Kreyl/LedPicture/Control/beleriand.jpg

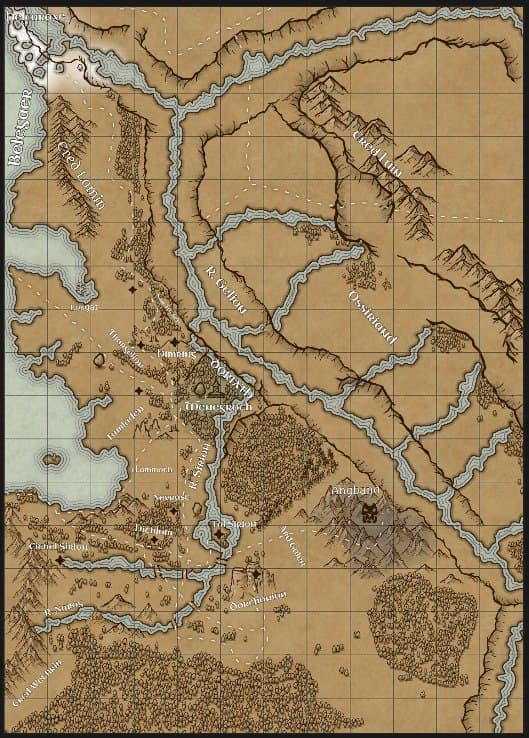
Control/beleriand.jpg
