Kreyl/LedPicture/LedPicture_hw/LedPicture.kicad_pcb

## KiCad design LedPicture_hw/LedPicture.kicad_pcb (2021-07-11)

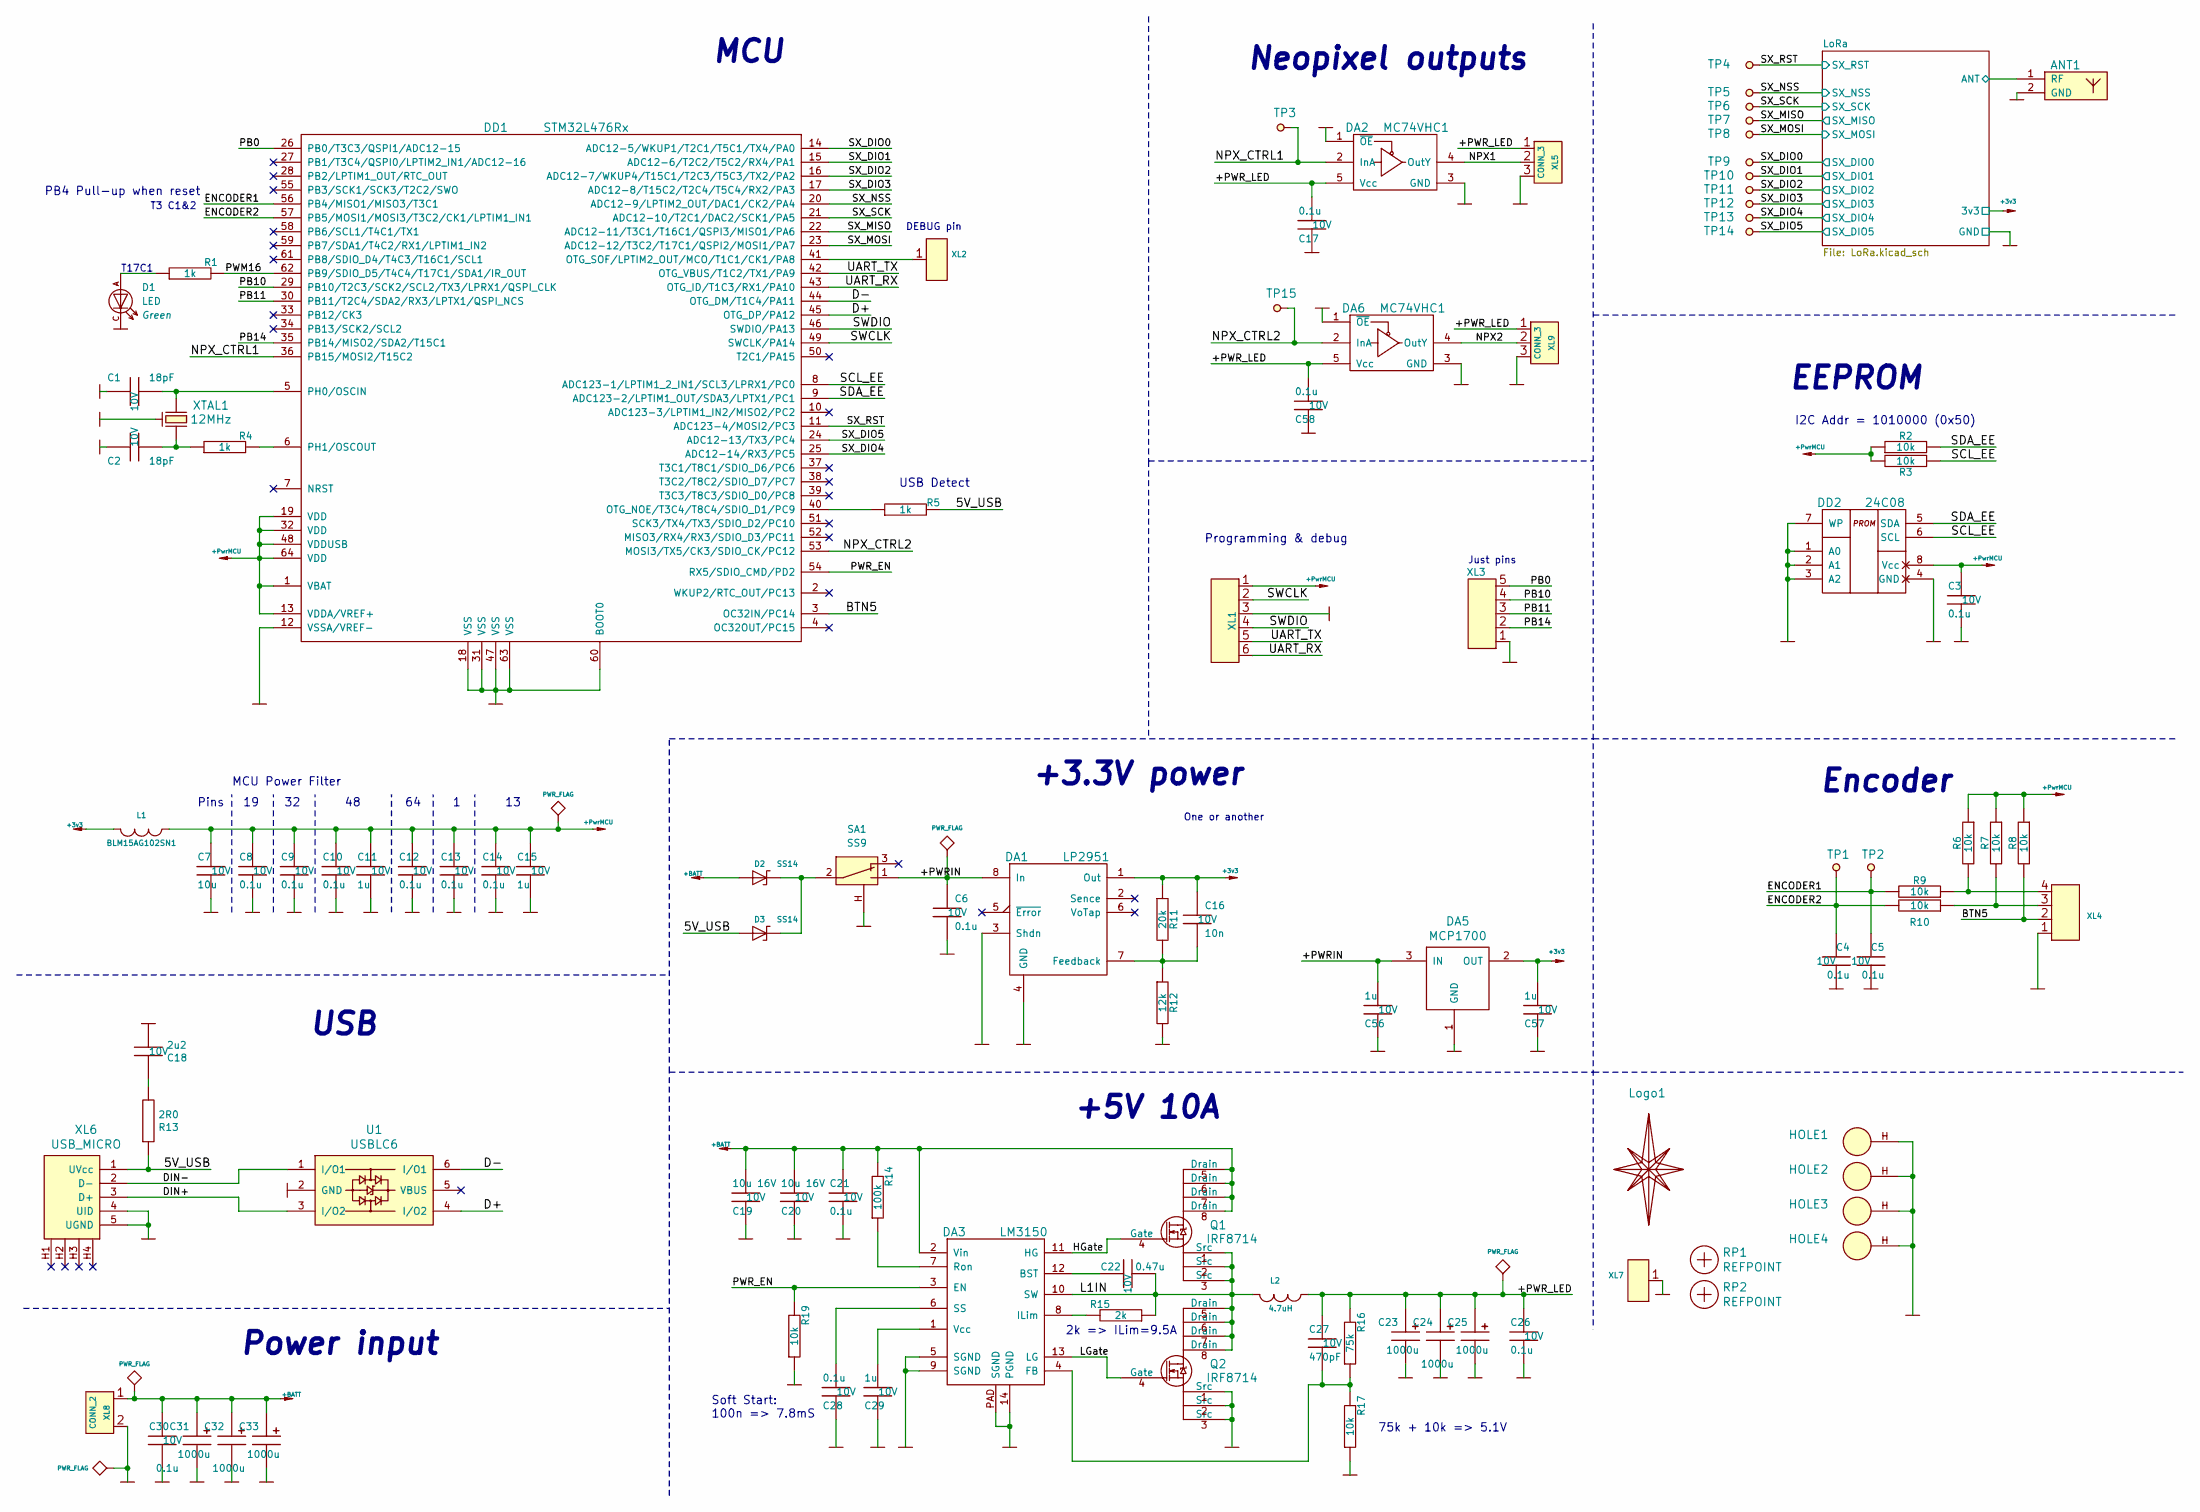
[picture p2: schematic LedPicture.kicad_sch]

Parts:
ANT1: ANT_GENERAL; ANT_868_IFA_SIMPLEJOY
C1, C2: 18pF; CAP_0603_Silks; Tolerance 20%; Voltage 10V
C3, C4, C5, C6, C8, C9, C10, C12, C13, C14, C17, C21, C26, C28, C30, C58: 0.1u; CAP_0603_Silks; Tolerance 20%; Voltage 10V
C7: 10u; CAP_0603_Silks; Tolerance 20%; Voltage 10V
C11, C15, C29, C56, C57: 1u; CAP_0603_Silks; Tolerance 20%; Voltage 10V
C16: 10n; CAP_0603_Silks; Tolerance 20%; Voltage 10V
C18: 2u2; CAP_0603_Silks; Tolerance 20%; Voltage 10V
C19, C20: 10u 16V; CAP_0603_Silks; Tolerance 20%; Voltage 10V
C22: 0.47u; CAP_0603_Silks; Tolerance 20%; Voltage 10V
C23, C24, C25, C31, C32, C33: 1000u; CAP_10xxR
C27: 470pF; CAP_0603_Silks; Tolerance 20%; Voltage 10V
D1: LED; LED_0603
D2, D3: SS14; SMA_DO214AC
DA1: LP2951; SO8_150MIL
DA2, DA6: MC74VHC1; SOT23-5
DA3: LM3150; HTSSOP14
DA5: MCP1700; SOT23-3A
DD1: STM32L476Rx; LQFP64
DD2: 24C08; SO8_150MIL
HOLE1, HOLE2, HOLE3, HOLE4: HOLE_METALLED; Hole3_5_out6mm
L1: BLM15AG102SN1; IND_0402; Tolerance 20%
L2: 4.7uH; 13x13
Logo1: Logo; Ostranna_16d9_13d5
Q1, Q2: IRF8714; SO8_150MIL
R1, R4, R5: 1k; RES_0603; Tolerance 1%
R2, R3, R6, R7, R8, R9, R10, R17, R19: 10k; RES_0603; Tolerance 1%
R11: 20k; RES_0603; Tolerance 1%
R12: 12k; RES_0603; Tolerance 1%
R13: 2R0; RES_0603; Tolerance 1%
R14: 100k; RES_0603; Tolerance 1%
R15: 2k; RES_0603; Tolerance 1%
R16: 75k; RES_0603; Tolerance 1%
RP1, RP2: REFPOINT; REF_POINT_1MM
SA1: SS9; SW_SS9
TP1, TP2, TP3, TP4, TP5, TP6, TP7, TP8, TP9, TP10, TP11, TP12, TP13, TP14, TP15: TESTPOINT; TESTPOINT_1MM
U1: USBLC6; SOT23-6
XL1: CONN_6; PLS-6_LOCK
XL2, XL7: CONN_1; PLS-1Rnd
XL3: CONN_5; PLS-5
XL4: CONN_4; WB-04(MW-4M)
XL5, XL9: CONN_3; TermiBlockHeader_508_x3_R
XL6: USB_MICRO; USBmicro_MOLEX_1050170001
XL8: CONN_2; TermiBlockHeader_508_x2_R
XTAL1: 12MHz; 03225C4

Connections:
+3v3: C16.1, C57.1, DA1.1 (Out), DA5.2 (OUT), L1.2, R11.1; also elsewhere on the board
+BATT: C19.1, C20.1, C21.2, C30.2, C31.1, C32.1, C33.1, D2.A, DA3.2 (Vin), Q1.5 (Drain), Q1.6 (Drain), Q1.7 (Drain), Q1.8 (Drain), R14.2, XL8.1
/5V_USB: D3.A, R5.2, R13.1, XL6.1 (UVcc)
/+PWRIN: C6.1, C56.1, DA1.8 (In), DA5.3 (IN), SA1.1
/+PWR_LED: C17.1, C23.1, C24.1, C25.1, C26.2, C27.2, C58.1, DA2.5 (Vcc), DA6.5 (Vcc), L2.1, R16.2, XL5.1, XL9.1
/BTN5: DD1.3 (OC32IN/PC14), R8.2, XL4.2 (PM)
/D+: DD1.45 (OTG_DP/PA12), U1.4 (I/O2)
/D-: DD1.44 (OTG_DM/T1C4/PA11), U1.6 (I/O1)
/DIN+: U1.3 (I/O2), XL6.3 (D+)
/DIN-: U1.1 (I/O1), XL6.2 (D-)
/ENCODER1: C5.2, DD1.56 (PB4/MISO1/MISO3/T3C1), R9.2, TP2.1
/ENCODER2: C4.2, DD1.57 (PB5/MOSI1/MOSI3/T3C2/CK1/LPTIM1_IN1), R10.2, TP1.1
/HGate: DA3.11 (HG), Q1.4 (Gate)
/L1IN: C22.1, DA3.10 (SW), L2.2, Q1.1 (Src), Q1.2 (Src), Q1.3 (Src), Q2.5 (Drain), Q2.6 (Drain), Q2.7 (Drain), Q2.8 (Drain), R15.1
/LGate: DA3.13 (LG), Q2.4 (Gate)
/LoRa/ANT: ANT1.1 (RF); also elsewhere on the board
/NPX1: DA2.4 (OutY), XL5.2 (PM)
/NPX2: DA6.4 (OutY), XL9.2 (PM)
/NPX_CTRL1: DA2.2 (InA), DD1.36 (PB15/MOSI2/T15C2), TP3.1
/NPX_CTRL2: DA6.2 (InA), DD1.53 (MOSI3/TX5/CK3/SDIO_CK/PC12), TP15.1
/PB0: DD1.26 (PB0/T3C3/QSPI1/ADC12-15), XL3.5
/PB10: DD1.29 (PB10/T2C3/SCK2/SCL2/TX3/LPRX1/QSPI_CLK), XL3.4
/PB11: DD1.30 (PB11/T2C4/SDA2/RX3/LPTX1/QSPI_NCS), XL3.3
/PB14: DD1.35 (PB14/MISO2/SDA2/T15C1), XL3.2
/PWM16: DD1.62 (PB9/SDIO_D5/T4C4/T17C1/SDA1/IR_OUT), R1.2
/PWR_EN: DA3.3 (EN), DD1.54 (RX5/SDIO_CMD/PD2), R19.2
/SCL_EE: DD1.8 (ADC123-1/LPTIM1_2_IN1/SCL3/LPRX1/PC0), DD2.6 (SCL), R3.1
/SDA_EE: DD1.9 (ADC123-2/LPTIM1_OUT/SDA3/LPTX1/PC1), DD2.5 (SDA), R2.2
/SWCLK: DD1.49 (SWCLK/PA14), XL1.2
/SWDIO: DD1.46 (SWDIO/PA13), XL1.4
/SX_DIO0: DD1.14 (ADC12-5/WKUP1/T2C1/T5C1/TX4/PA0), TP9.1; also elsewhere on the board
/SX_DIO1: DD1.15 (ADC12-6/T2C2/T5C2/RX4/PA1), TP10.1; also elsewhere on the board
/SX_DIO2: DD1.16 (ADC12-7/WKUP4/T15C1/T2C3/T5C3/TX2/PA2), TP11.1; also elsewhere on the board
/SX_DIO3: DD1.17 (ADC12-8/T15C2/T2C4/T5C4/RX2/PA3), TP12.1; also elsewhere on the board
/SX_DIO4: DD1.25 (ADC12-14/RX3/PC5), TP13.1; also elsewhere on the board
/SX_DIO5: DD1.24 (ADC12-13/TX3/PC4), TP14.1; also elsewhere on the board
/SX_MISO: DD1.22 (ADC12-11/T3C1/T16C1/QSPI3/MISO1/PA6), TP7.1; also elsewhere on the board
/SX_MOSI: DD1.23 (ADC12-12/T3C2/T17C1/QSPI2/MOSI1/PA7), TP8.1; also elsewhere on the board
/SX_NSS: DD1.20 (ADC12-9/LPTIM2_OUT/DAC1/CK2/PA4), TP5.1; also elsewhere on the board
/SX_RST: DD1.11 (ADC123-4/MOSI2/PC3), TP4.1; also elsewhere on the board
/SX_SCK: DD1.21 (ADC12-10/T2C1/DAC2/SCK1/PA5), TP6.1; also elsewhere on the board
/UART_RX: DD1.43 (OTG_ID/T1C3/RX1/PA10), XL1.6
/UART_TX: DD1.42 (OTG_VBUS/T1C2/TX1/PA9), XL1.5
GND: ANT1.2 (GND), C1.2, C2.2, C3.1, C4.1, C5.1, C6.2, C7.1, C8.1, C9.1, C10.1, C11.1, C12.1, C13.1, C14.1, C15.1, C17.2, C18.2, C19.2, C20.2, C21.1, C23.2, C24.2, C25.2, C26.1, C28.2, C29.2, C30.1, C31.2, C32.2, C33.2, C56.2, C57.2, C58.2, D1.C, DA1.3 (Shdn), DA1.4 (GND), DA2.1 (~OE), DA2.3 (GND), DA3.5 (SGND), DA3.9 (SGND), DA3.14 (PGND), DA3.PAD (SGND), DA5.1 (GND), DA6.1 (~OE), DA6.3 (GND), DD1.12 (VSSA/VREF-), DD1.18 (VSS), DD1.31 (VSS), DD1.47 (VSS), DD1.60 (BOOT0), DD1.63 (VSS), DD2.1 (A0), DD2.2 (A1), DD2.3 (A2), DD2.4 (GND), DD2.7 (WP), HOLE1.H, HOLE2.H, HOLE3.H, HOLE4.H, Q2.1 (Src), Q2.2 (Src), Q2.3 (Src), R12.2, R17.1, R19.1, SA1.H, U1.2 (GND), XL1.3, XL3.1, XL4.1, XL5.3, XL6.4 (UID), XL6.5 (UGND), XL7.1, XL8.2 (PM), XL9.3, XTAL1.H; also elsewhere on the board
unnamed: C1.1, DD1.5 (PH0/OSCIN), XTAL1.1
unnamed: C2.1, R4.1, XTAL1.2
unnamed: C16.2, DA1.7 (Feedback), R11.2, R12.1
unnamed: C18.1, R13.2
unnamed: C22.2, DA3.12 (BST)
unnamed: C27.1, DA3.4 (FB), R16.1, R17.2
unnamed: C28.1, DA3.6 (SS)
unnamed: C29.1, DA3.1 (Vcc)
unnamed: D1.A, R1.1
unnamed: D2.C, D3.C, SA1.2
unnamed: DA3.7 (Ron), R14.1
unnamed: DA3.8 (ILim), R15.2
unnamed: DD1.6 (PH1/OSCOUT), R4.2
unnamed: DD1.40 (OTG_NOE/T3C4/T8C4/SDIO_D1/PC9), R5.1
unnamed: DD1.41 (OTG_SOF/LPTIM2_OUT/MCO/T1C1/CK1/PA8), XL2.1
unnamed: R6.2, R9.1, XL4.4
unnamed: R7.2, R10.1, XL4.3

Notes on the sheet:
PB4 Pull-up when reset
T17C1
T3 C1&2
Pins 19 32 48 64 1 13
MCU Power Filter
Power input
USB
MCU
Soft Start: 100n => 7.8mS
USB Detect
DEBUG pin
+3.3V power
2k => ILim=9.5A
+5V 10A
One or another
Programming & debug
Neopixel outputs
75k + 10k => 5.1V
Just pins
EEPROM
I2C Addr = 1010000 (0x50)
Encoder

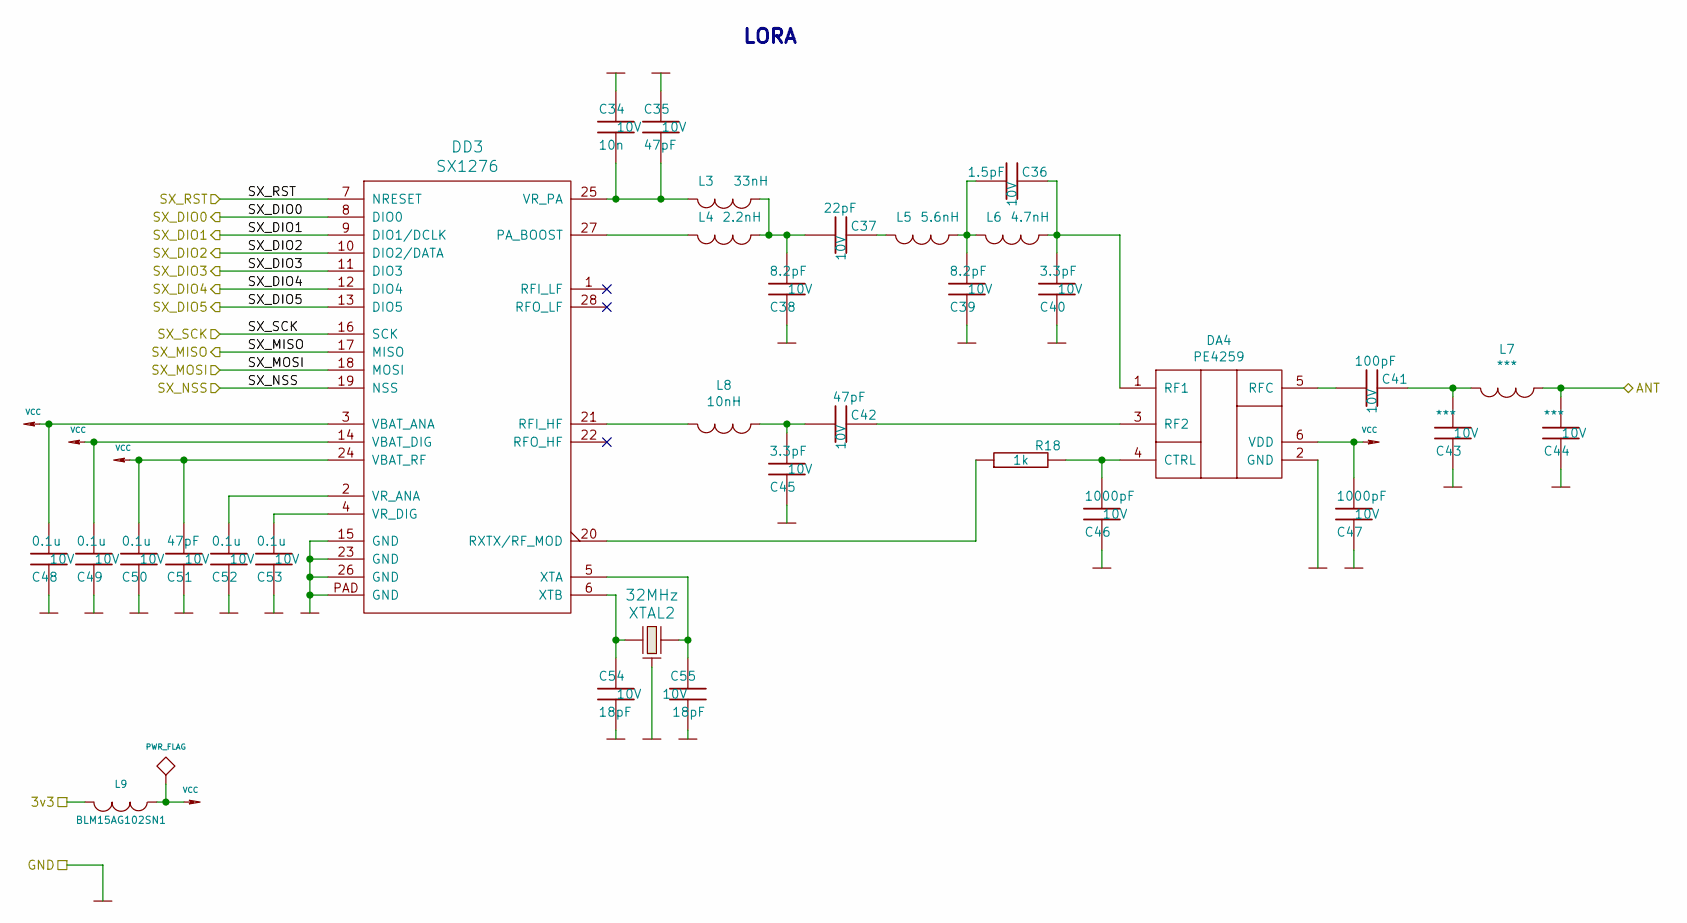
[picture p3: schematic LoRa.kicad_sch]

Parts:
C34: 10n; CAP_0402; Tolerance 20%; Voltage 10V
C35, C42, C51: 47pF; CAP_0402; Tolerance 20%; Voltage 10V
C36: 1.5pF; CAP_0402; Tolerance 20%; Voltage 10V
C37: 22pF; CAP_0402; Tolerance 20%; Voltage 10V
C38, C39: 8.2pF; CAP_0402; Tolerance 20%; Voltage 10V
C40, C45: 3.3pF; CAP_0402; Tolerance 20%; Voltage 10V
C41: 100pF; CAP_0402; Tolerance 20%; Voltage 10V
C43, C44: ***; CAP_0402; Tolerance 20%; Voltage 10V
C46, C47: 1000pF; CAP_0402; Tolerance 20%; Voltage 10V
C48, C49, C50, C52, C53: 0.1u; CAP_0402; Tolerance 20%; Voltage 10V
C54, C55: 18pF; CAP_0603_Silks; Tolerance 20%; Voltage 10V
DA4: PE4259; SC70
DD3: SX1276; QFN-28_EP_6x6_Pitch0.65mm
L3: 33nH; IND_0402; Tolerance 20%
L4: 2.2nH; IND_0402; Tolerance 20%
L5: 5.6nH; IND_0402; Tolerance 20%
L6: 4.7nH; IND_0402; Tolerance 20%
L7: ***; IND_0402; Tolerance 20%
L8: 10nH; IND_0402; Tolerance 20%
L9: BLM15AG102SN1; IND_0402; Tolerance 20%
R18: 1k; RES_0603; Tolerance 1%
XTAL2: 32MHz; 03225C4

Connections:
+3v3: L9.2; also elsewhere on the board
/LoRa/ANT: C44.1, L7.2; also elsewhere on the board
/SX_DIO0: DD3.8 (DIO0); also elsewhere on the board
/SX_DIO1: DD3.9 (DIO1/DCLK); also elsewhere on the board
/SX_DIO2: DD3.10 (DIO2/DATA); also elsewhere on the board
/SX_DIO3: DD3.11 (DIO3); also elsewhere on the board
/SX_DIO4: DD3.12 (DIO4); also elsewhere on the board
/SX_DIO5: DD3.13 (DIO5); also elsewhere on the board
/SX_MISO: DD3.17 (MISO); also elsewhere on the board
/SX_MOSI: DD3.18 (MOSI); also elsewhere on the board
/SX_NSS: DD3.19 (NSS); also elsewhere on the board
/SX_RST: DD3.7 (NRESET); also elsewhere on the board
/SX_SCK: DD3.16 (SCK); also elsewhere on the board
GND: C34.2, C35.2, C38.2, C39.2, C40.2, C43.2, C44.2, C45.2, C46.2, C47.2, C48.2, C49.2, C50.2, C51.2, C52.2, C53.2, C54.2, C55.2, DA4.2 (GND), DD3.15 (GND), DD3.23 (GND), DD3.26 (GND), DD3.PAD (GND), XTAL2.H; also elsewhere on the board
unnamed: C34.1, C35.1, DD3.25 (VR_PA), L3.1
unnamed: C36.1, C40.1, DA4.1 (RF1), L6.2
unnamed: C36.2, C39.1, L5.2, L6.1
unnamed: C37.1, L5.1
unnamed: C37.2, C38.1, L3.2, L4.2
unnamed: C41.1, C43.1, L7.1
unnamed: C41.2, DA4.5 (RFC)
unnamed: C42.1, DA4.3 (RF2)
unnamed: C42.2, C45.1, L8.2
unnamed: C46.1, DA4.4 (CTRL), R18.2
unnamed: C52.1, DD3.2 (VR_ANA)
unnamed: C53.1, DD3.4 (VR_DIG)
unnamed: C54.1, DD3.6 (XTB), XTAL2.2
unnamed: C55.1, DD3.5 (XTA), XTAL2.1
unnamed: DD3.20 (RXTX/RF_MOD), R18.1
unnamed: DD3.21 (RFI_HF), L8.1
unnamed: DD3.27 (PA_BOOST), L4.1
VCC: C47.1, C48.1, C49.1, C50.1, C51.1, DA4.6 (VDD), DD3.3 (VBAT_ANA), DD3.14 (VBAT_DIG), DD3.24 (VBAT_RF), L9.1

Notes on the sheet:
LORA

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
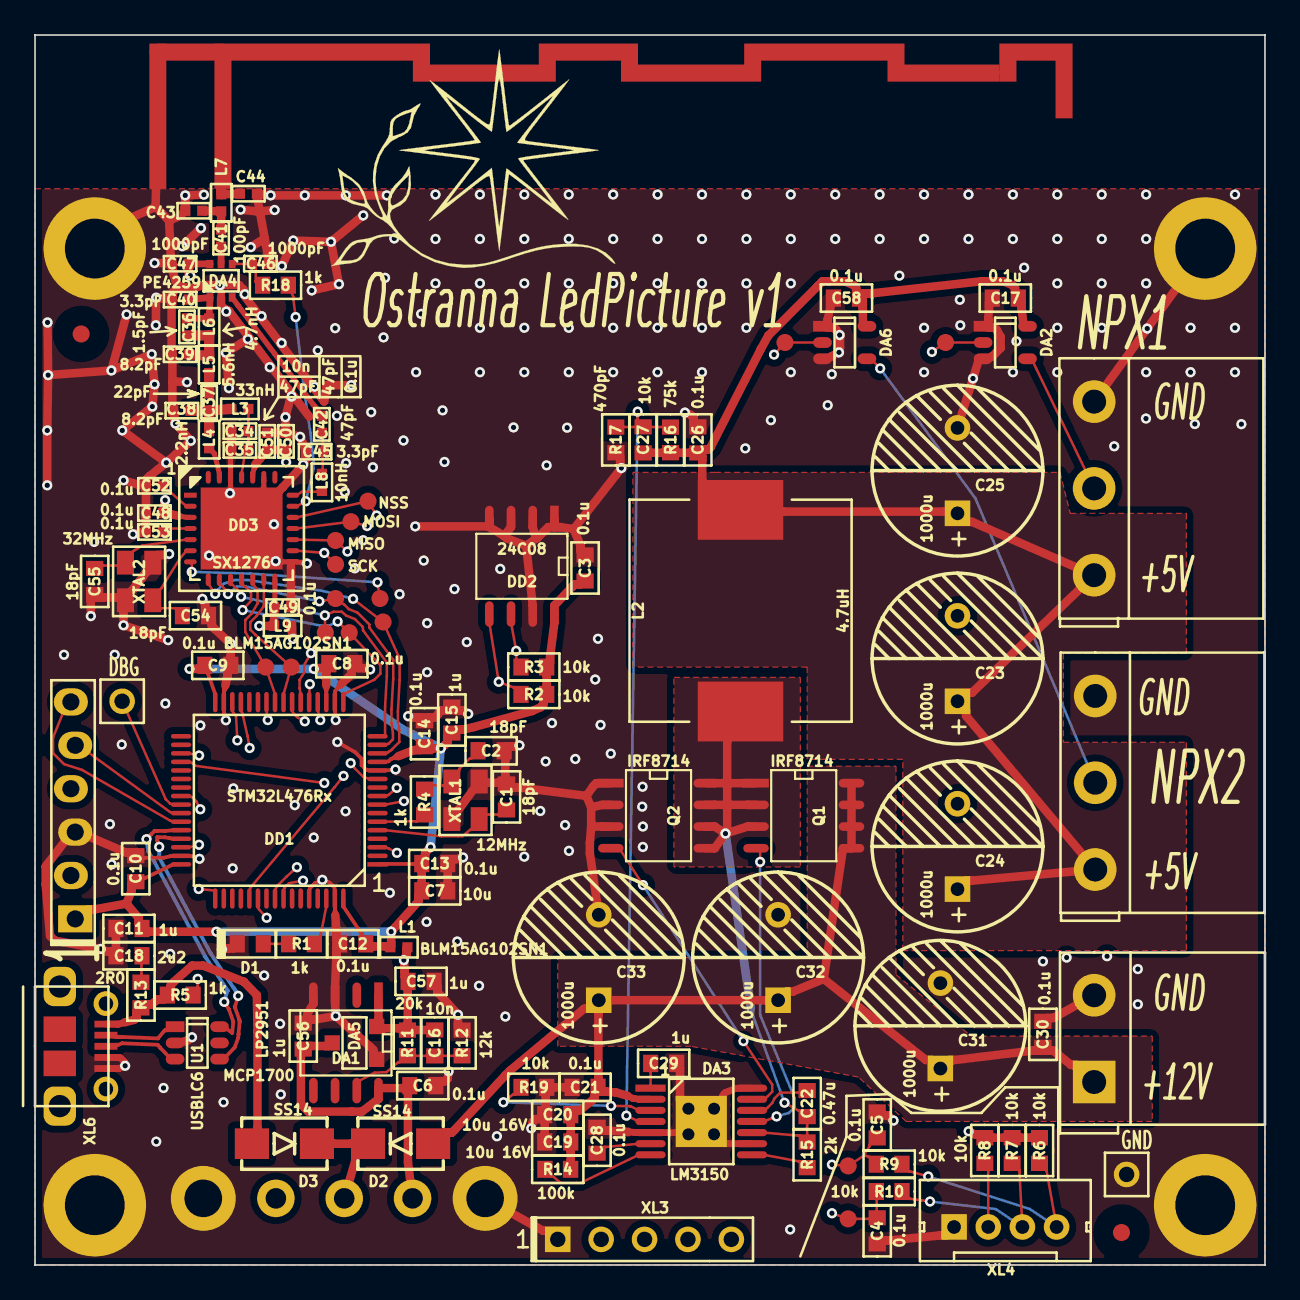
[picture p4: board LedPicture.kicad_pcb from above]

Board: 4 copper layers, 72.0 x 72.0 mm, 136 parts (1 on the bottom side), 80 nets.
