Kreyl/LedPicture/LedPcb10x14/LedPcb10x14.kicad_pcb

## KiCad design LedPcb10x14/LedPcb10x14.kicad_pcb (2021-07-11)

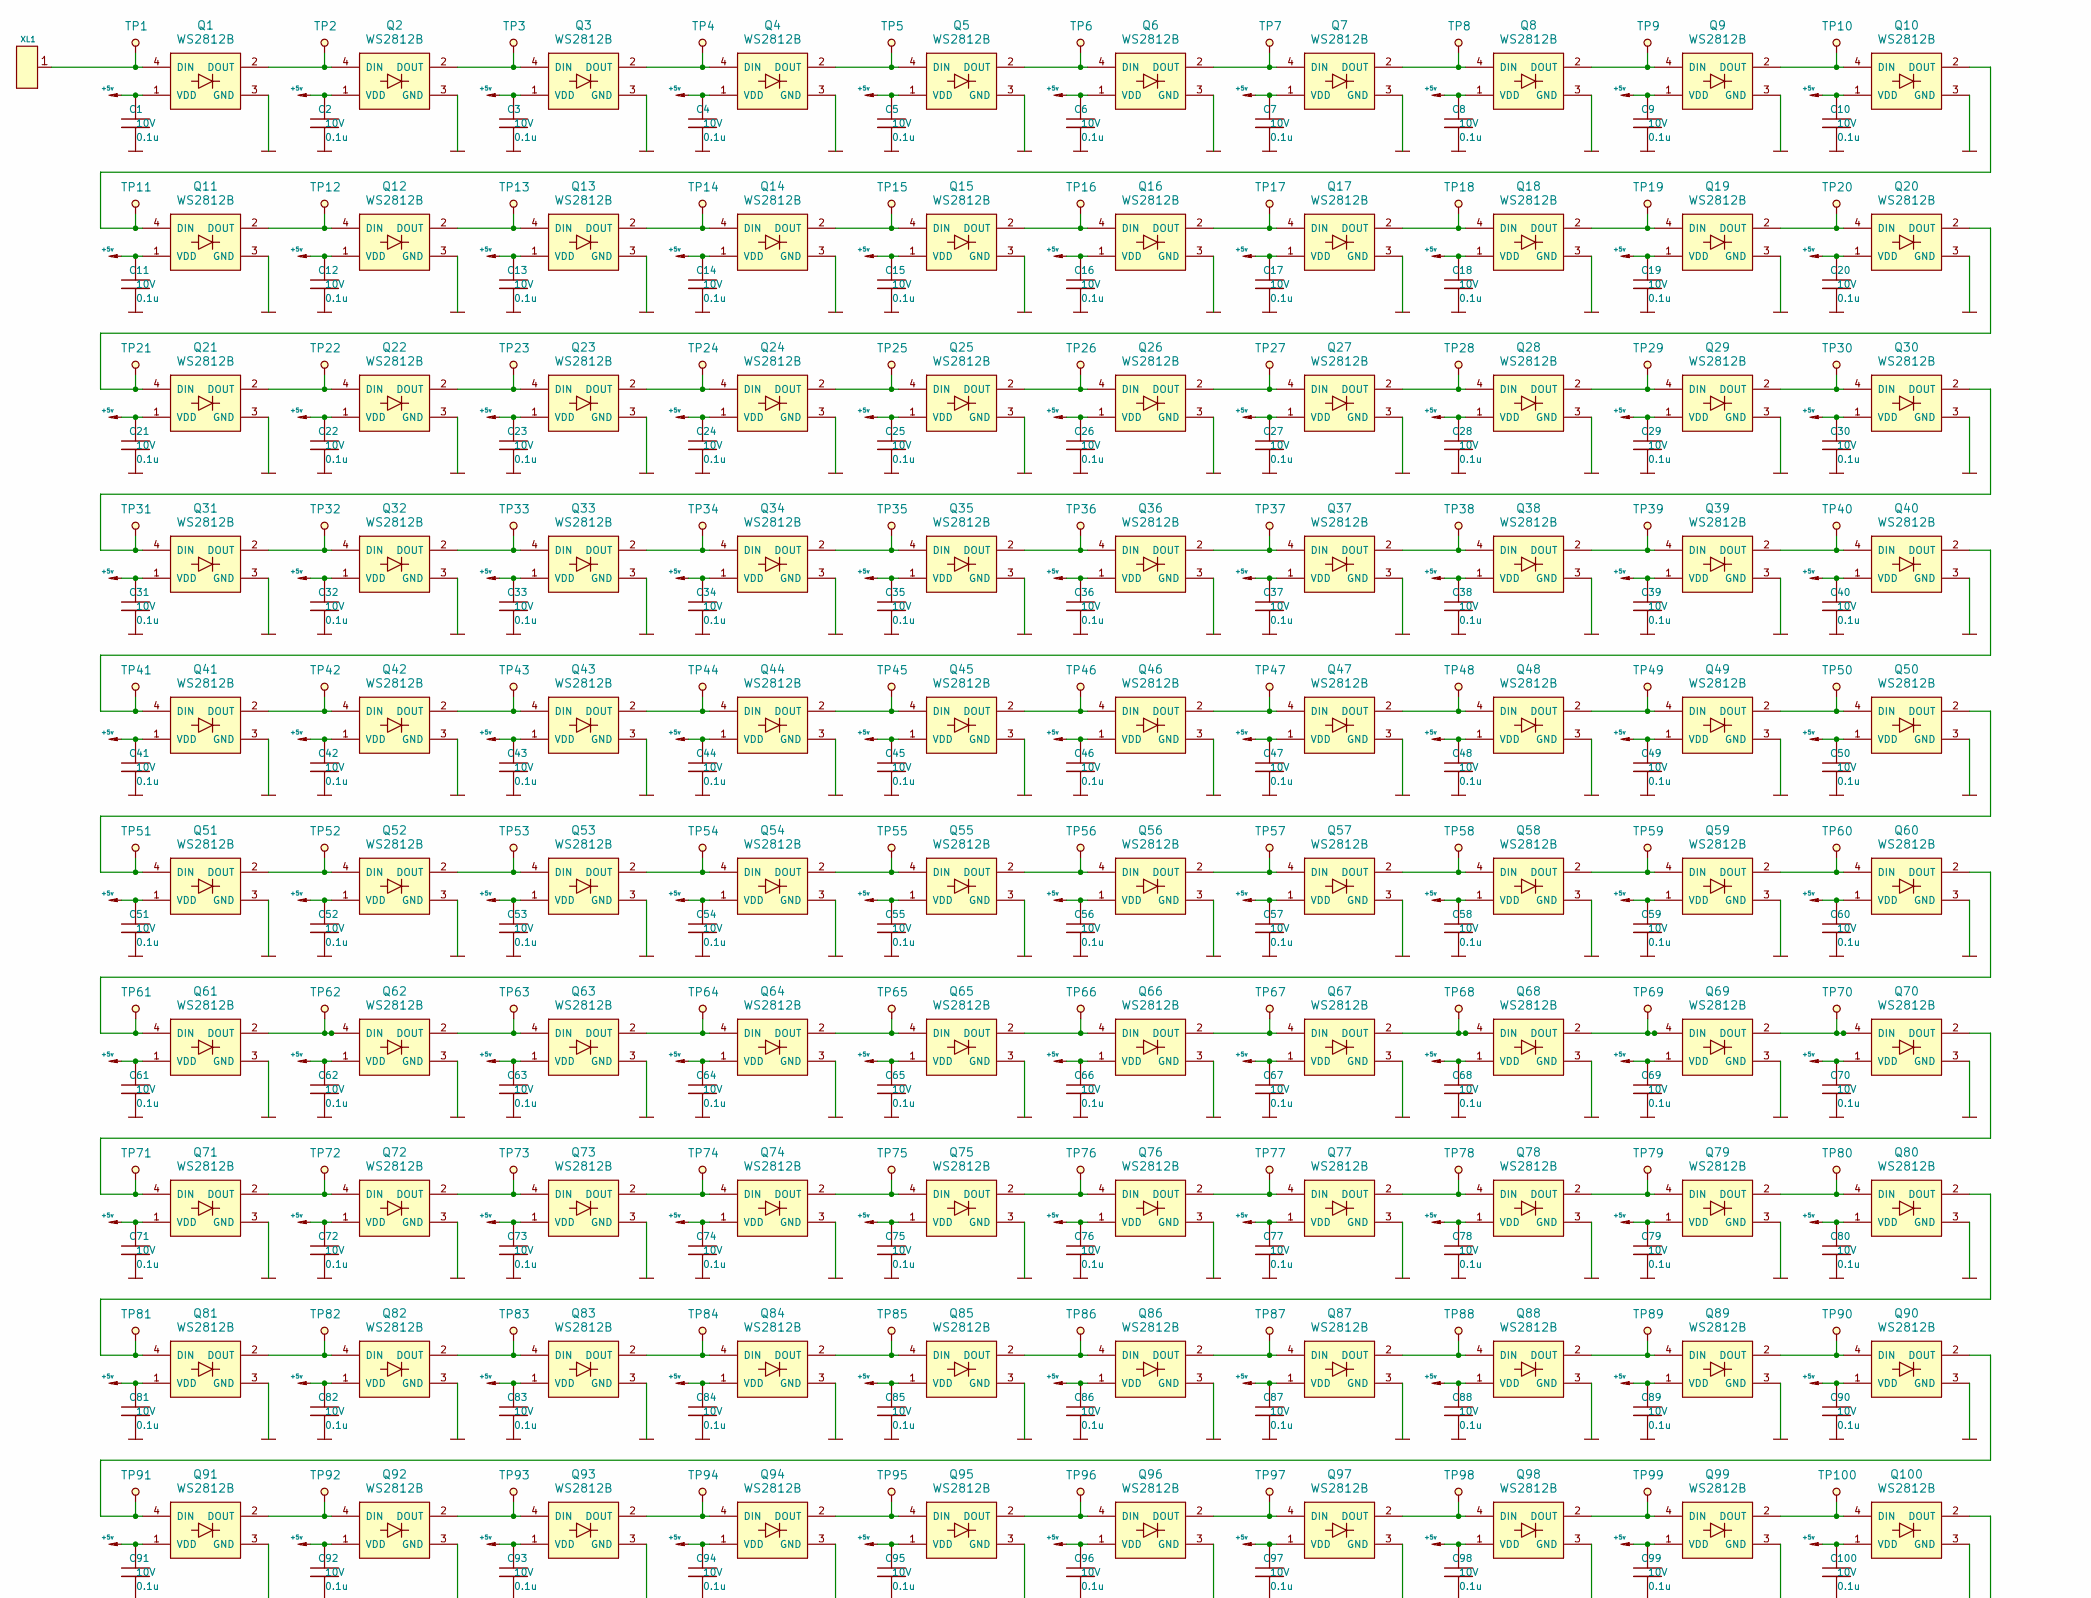
[picture p5: schematic LedPcb10x14.kicad_sch, part in row 1, column 1]

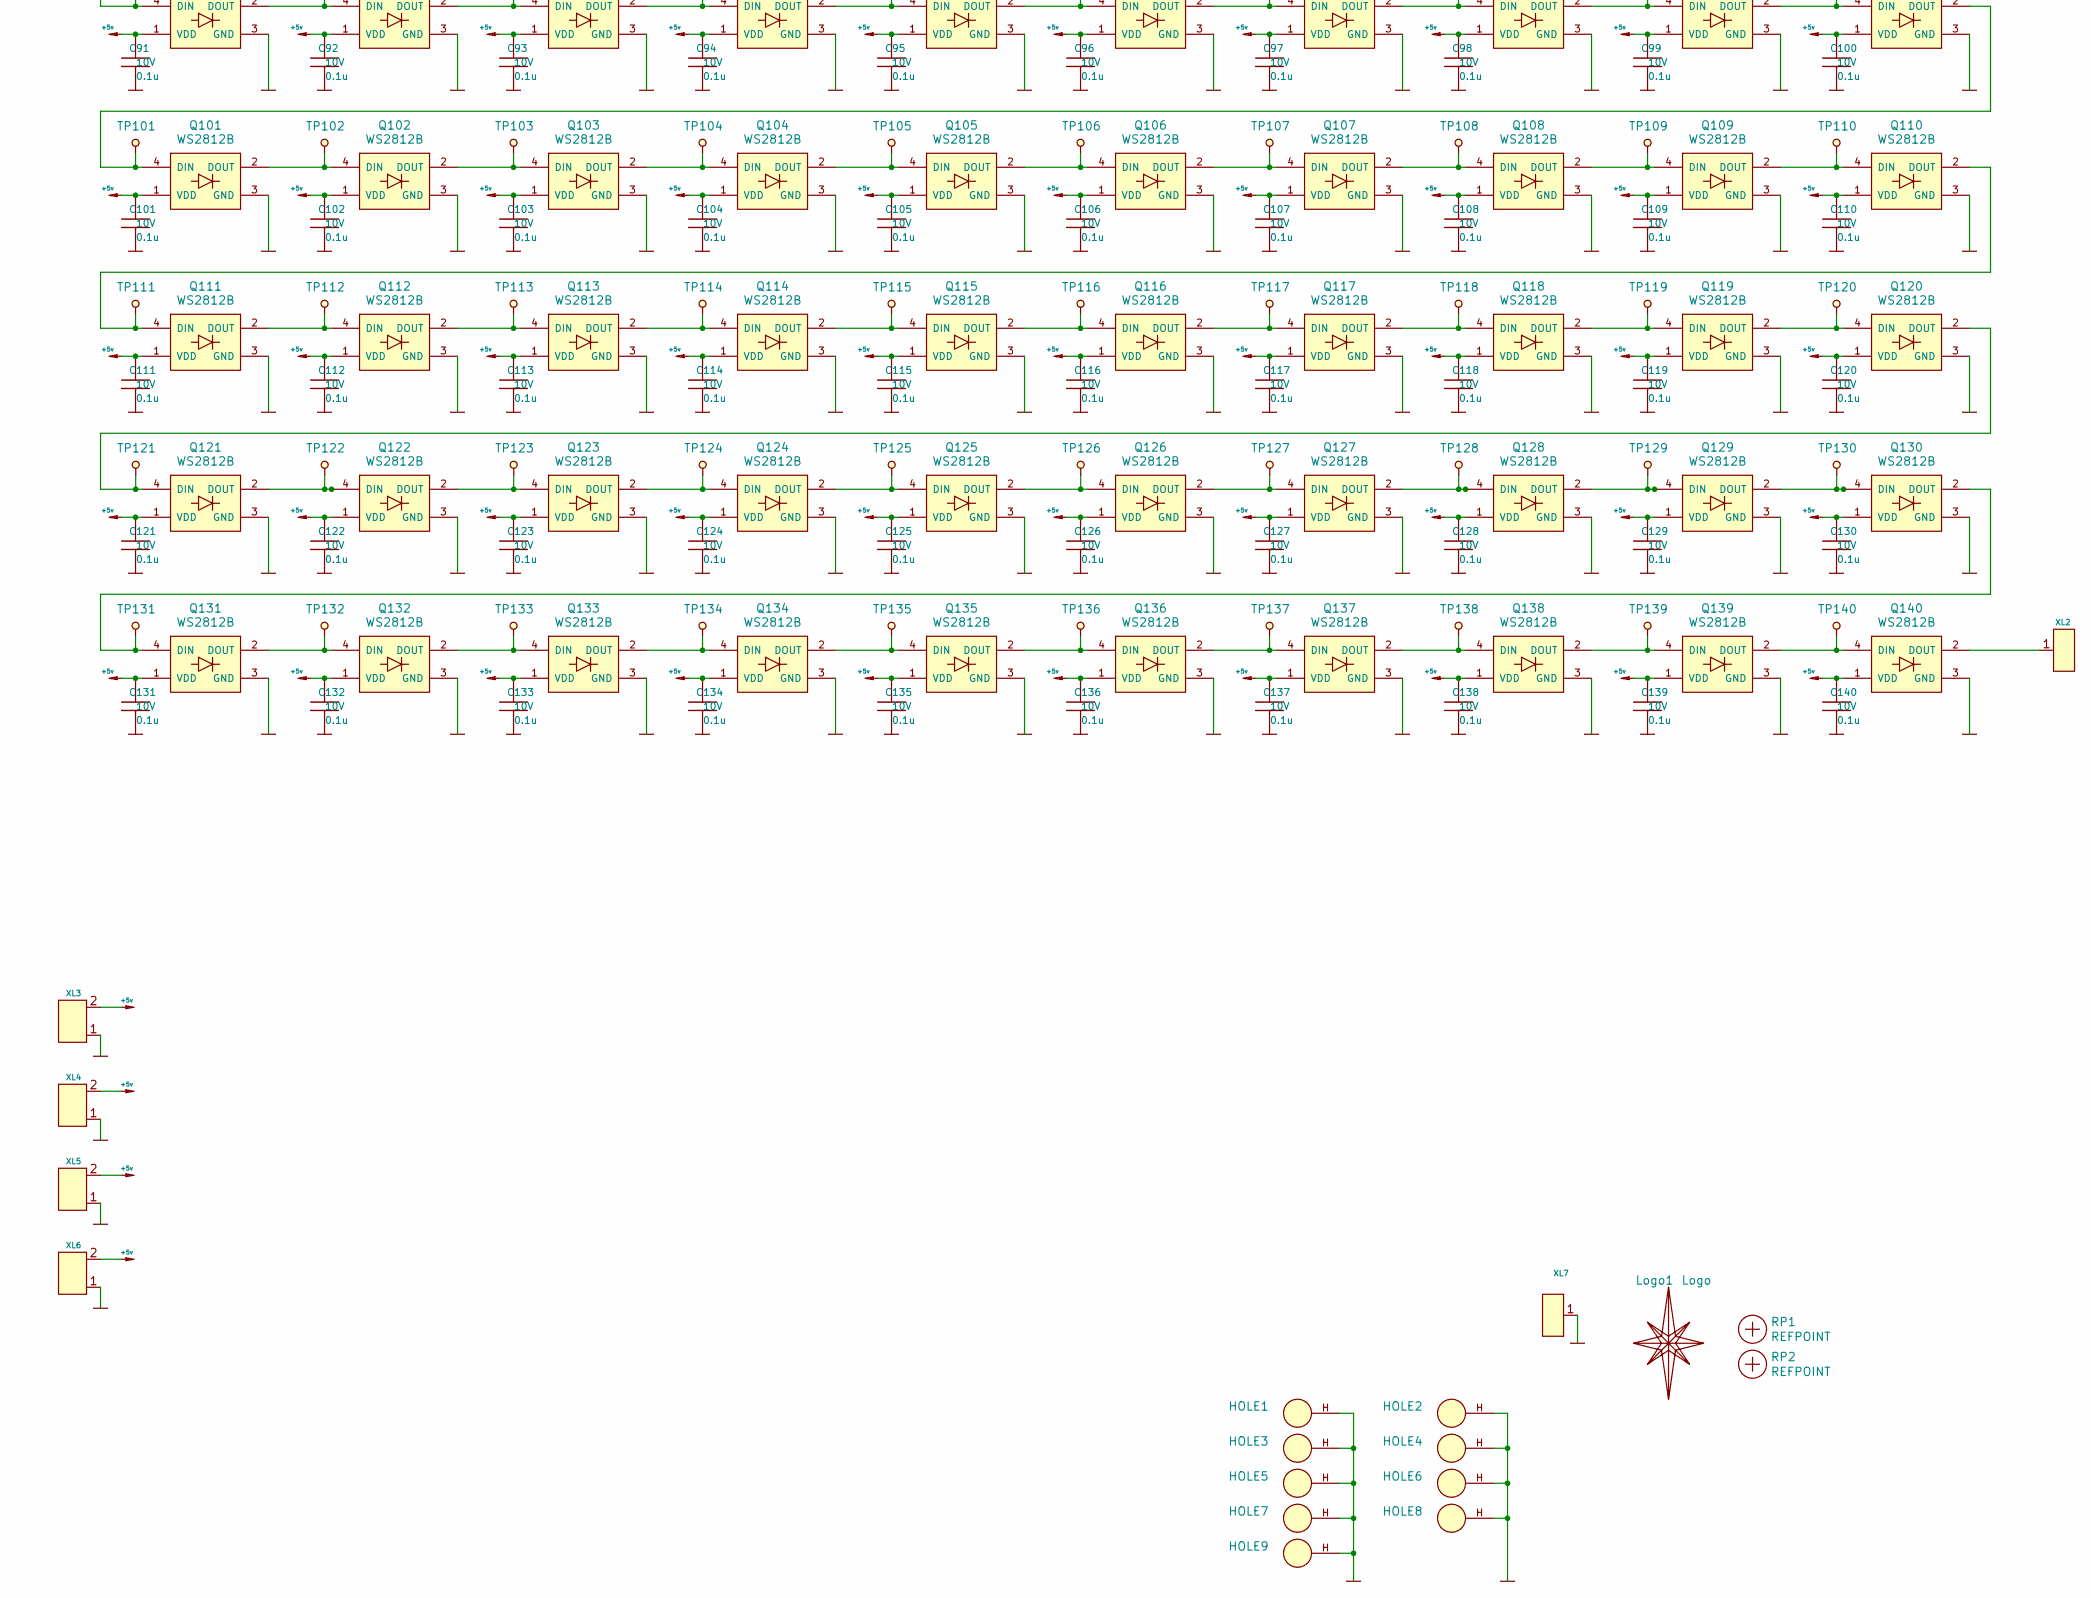
[picture p6: schematic LedPcb10x14.kicad_sch, part in row 2, column 1]

Parts:
C1, C2, C3, C4, C5, C6, C7, C8, C9, C10, C11, C12, C13, C14, C15, C16, C17, C18, C19, C20, C21, C22, C23, C24, C25, C26, C27, C28, C29, C30, C31, C32, C33, C34, C35, C36, C37, C38, C39, C40, C41, C42, C43, C44, C45, C46, C47, C48, C49, C50, C51, C52, C53, C54, C55, C56, C57, C58, C59, C60, C61, C62, C63, C64, C65, C66, C67, C68, C69, C70, C71, C72, C73, C74, C75, C76, C77, C78, C79, C80, C81, C82, C83, C84, C85, C86, C87, C88, C89, C90, C91, C92, C93, C94, C95, C96, C97, C98, C99, C100, C101, C102, C103, C104, C105, C106, C107, C108, C109, C110, C111, C112, C113, C114, C115, C116, C117, C118, C119, C120, C121, C122, C123, C124, C125, C126, C127, C128, C129, C130, C131, C132, C133, C134, C135, C136, C137, C138, C139, C140: 0.1u; CAP_0603_Silks; Tolerance 20%; Voltage 10V
HOLE1, HOLE2, HOLE3, HOLE4, HOLE5, HOLE6, HOLE7, HOLE8, HOLE9: HOLE_METALLED; Hole2d2_out3d5mm
Logo1: Logo; Ostranna_12d7_10d1
Q1, Q2, Q3, Q4, Q5, Q6, Q7, Q8, Q9, Q10, Q11, Q12, Q13, Q14, Q15, Q16, Q17, Q18, Q19, Q20, Q21, Q22, Q23, Q24, Q25, Q26, Q27, Q28, Q29, Q30, Q31, Q32, Q33, Q34, Q35, Q36, Q37, Q38, Q39, Q40, Q41, Q42, Q43, Q44, Q45, Q46, Q47, Q48, Q49, Q50, Q51, Q52, Q53, Q54, Q55, Q56, Q57, Q58, Q59, Q60, Q61, Q62, Q63, Q64, Q65, Q66, Q67, Q68, Q69, Q70, Q71, Q72, Q73, Q74, Q75, Q76, Q77, Q78, Q79, Q80, Q81, Q82, Q83, Q84, Q85, Q86, Q87, Q88, Q89, Q90, Q91, Q92, Q93, Q94, Q95, Q96, Q97, Q98, Q99, Q100, Q101, Q102, Q103, Q104, Q105, Q106, Q107, Q108, Q109, Q110, Q111, Q112, Q113, Q114, Q115, Q116, Q117, Q118, Q119, Q120, Q121, Q122, Q123, Q124, Q125, Q126, Q127, Q128, Q129, Q130, Q131, Q132, Q133, Q134, Q135, Q136, Q137, Q138, Q139, Q140: WS2812B; LED_WS2812B
RP1, RP2: REFPOINT; REF_POINT_1MM
TP1, TP2, TP3, TP4, TP5, TP6, TP7, TP8, TP9, TP10, TP11, TP12, TP13, TP14, TP15, TP16, TP17, TP18, TP19, TP20, TP21, TP22, TP23, TP24, TP25, TP26, TP27, TP28, TP29, TP30, TP31, TP32, TP33, TP34, TP35, TP36, TP37, TP38, TP39, TP40, TP41, TP42, TP43, TP44, TP45, TP46, TP47, TP48, TP49, TP50, TP51, TP52, TP53, TP54, TP55, TP56, TP57, TP58, TP59, TP60, TP61, TP62, TP63, TP64, TP65, TP66, TP67, TP68, TP69, TP70, TP71, TP72, TP73, TP74, TP75, TP76, TP77, TP78, TP79, TP80, TP81, TP82, TP83, TP84, TP85, TP86, TP87, TP88, TP89, TP90, TP91, TP92, TP93, TP94, TP95, TP96, TP97, TP98, TP99, TP100, TP101, TP102, TP103, TP104, TP105, TP106, TP107, TP108, TP109, TP110, TP111, TP112, TP113, TP114, TP115, TP116, TP117, TP118, TP119, TP120, TP121, TP122, TP123, TP124, TP125, TP126, TP127, TP128, TP129, TP130, TP131, TP132, TP133, TP134, TP135, TP136, TP137, TP138, TP139, TP140: TESTPOINT; TESTPOINT_1MM
XL1, XL2: CONN_1; PLS-1Oval
XL3, XL4, XL5, XL6: CONN_2; TermiBlockHeader_508_x2_R
XL7: CONN_1; PLS-1Square

Connections:
+5v: C1.1, C2.1, C3.1, C4.1, C5.1, C6.1, C7.1, C8.1, C9.1, C10.1, C11.1, C12.1, C13.1, C14.1, C15.1, C16.1, C17.1, C18.1, C19.1, C20.1, C21.1, C22.1, C23.1, C24.1, C25.1, C26.1, C27.1, C28.1, C29.1, C30.1, C31.1, C32.1, C33.1, C34.1, C35.1, C36.1, C37.1, C38.1, C39.1, C40.1, C41.1, C42.1, C43.1, C44.1, C45.1, C46.1, C47.1, C48.1, C49.1, C50.1, C51.1, C52.1, C53.1, C54.1, C55.1, C56.1, C57.1, C58.1, C59.1, C60.1, C61.1, C62.1, C63.1, C64.1, C65.1, C66.1, C67.1, C68.1, C69.1, C70.1, C71.1, C72.1, C73.1, C74.1, C75.1, C76.1, C77.1, C78.1, C79.1, C80.1, C81.1, C82.1, C83.1, C84.1, C85.1, C86.1, C87.1, C88.1, C89.1, C90.1, C91.1, C92.1, C93.1, C94.1, C95.1, C96.1, C97.1, C98.1, C99.1, C100.1, C101.1, C102.1, C103.1, C104.1, C105.1, C106.1, C107.1, C108.1, C109.1, C110.1, C111.1, C112.1, C113.1, C114.1, C115.1, C116.1, C117.1, C118.1, C119.1, C120.1, C121.1, C122.1, C123.1, C124.1, C125.1, C126.1, C127.1, C128.1, C129.1, C130.1, C131.1, C132.1, C133.1, C134.1, C135.1, C136.1, C137.1, C138.1, C139.1, C140.1, Q1.1 (VDD), Q2.1 (VDD), Q3.1 (VDD), Q4.1 (VDD), Q5.1 (VDD), Q6.1 (VDD), Q7.1 (VDD), Q8.1 (VDD), Q9.1 (VDD), Q10.1 (VDD), Q11.1 (VDD), Q12.1 (VDD), Q13.1 (VDD), Q14.1 (VDD), Q15.1 (VDD), Q16.1 (VDD), Q17.1 (VDD), Q18.1 (VDD), Q19.1 (VDD), Q20.1 (VDD), Q21.1 (VDD), Q22.1 (VDD), Q23.1 (VDD), Q24.1 (VDD), Q25.1 (VDD), Q26.1 (VDD), Q27.1 (VDD), Q28.1 (VDD), Q29.1 (VDD), Q30.1 (VDD), Q31.1 (VDD), Q32.1 (VDD), Q33.1 (VDD), Q34.1 (VDD), Q35.1 (VDD), Q36.1 (VDD), Q37.1 (VDD), Q38.1 (VDD), Q39.1 (VDD), Q40.1 (VDD), Q41.1 (VDD), Q42.1 (VDD), Q43.1 (VDD), Q44.1 (VDD), Q45.1 (VDD), Q46.1 (VDD), Q47.1 (VDD), Q48.1 (VDD), Q49.1 (VDD), Q50.1 (VDD), Q51.1 (VDD), Q52.1 (VDD), Q53.1 (VDD), Q54.1 (VDD), Q55.1 (VDD), Q56.1 (VDD), Q57.1 (VDD), Q58.1 (VDD), Q59.1 (VDD), Q60.1 (VDD), Q61.1 (VDD), Q62.1 (VDD), Q63.1 (VDD), Q64.1 (VDD), Q65.1 (VDD), Q66.1 (VDD), Q67.1 (VDD), Q68.1 (VDD), Q69.1 (VDD), Q70.1 (VDD), Q71.1 (VDD), Q72.1 (VDD), Q73.1 (VDD), Q74.1 (VDD), Q75.1 (VDD), Q76.1 (VDD), Q77.1 (VDD), Q78.1 (VDD), Q79.1 (VDD), Q80.1 (VDD), Q81.1 (VDD), Q82.1 (VDD), Q83.1 (VDD), Q84.1 (VDD), Q85.1 (VDD), Q86.1 (VDD), Q87.1 (VDD), Q88.1 (VDD), Q89.1 (VDD), Q90.1 (VDD), Q91.1 (VDD), Q92.1 (VDD), Q93.1 (VDD), Q94.1 (VDD), Q95.1 (VDD), Q96.1 (VDD), Q97.1 (VDD), Q98.1 (VDD), Q99.1 (VDD), Q100.1 (VDD), Q101.1 (VDD), Q102.1 (VDD), Q103.1 (VDD), Q104.1 (VDD), Q105.1 (VDD), Q106.1 (VDD), Q107.1 (VDD), Q108.1 (VDD), Q109.1 (VDD), Q110.1 (VDD), Q111.1 (VDD), Q112.1 (VDD), Q113.1 (VDD), Q114.1 (VDD), Q115.1 (VDD), Q116.1 (VDD), Q117.1 (VDD), Q118.1 (VDD), Q119.1 (VDD), Q120.1 (VDD), Q121.1 (VDD), Q122.1 (VDD), Q123.1 (VDD), Q124.1 (VDD), Q125.1 (VDD), Q126.1 (VDD), Q127.1 (VDD), Q128.1 (VDD), Q129.1 (VDD), Q130.1 (VDD), Q131.1 (VDD), Q132.1 (VDD), Q133.1 (VDD), Q134.1 (VDD), Q135.1 (VDD), Q136.1 (VDD), Q137.1 (VDD), Q138.1 (VDD), Q139.1 (VDD), Q140.1 (VDD), XL3.2 (PM), XL4.2 (PM), XL5.2 (PM), XL6.2 (PM)
GND: C1.2, C2.2, C3.2, C4.2, C5.2, C6.2, C7.2, C8.2, C9.2, C10.2, C11.2, C12.2, C13.2, C14.2, C15.2, C16.2, C17.2, C18.2, C19.2, C20.2, C21.2, C22.2, C23.2, C24.2, C25.2, C26.2, C27.2, C28.2, C29.2, C30.2, C31.2, C32.2, C33.2, C34.2, C35.2, C36.2, C37.2, C38.2, C39.2, C40.2, C41.2, C42.2, C43.2, C44.2, C45.2, C46.2, C47.2, C48.2, C49.2, C50.2, C51.2, C52.2, C53.2, C54.2, C55.2, C56.2, C57.2, C58.2, C59.2, C60.2, C61.2, C62.2, C63.2, C64.2, C65.2, C66.2, C67.2, C68.2, C69.2, C70.2, C71.2, C72.2, C73.2, C74.2, C75.2, C76.2, C77.2, C78.2, C79.2, C80.2, C81.2, C82.2, C83.2, C84.2, C85.2, C86.2, C87.2, C88.2, C89.2, C90.2, C91.2, C92.2, C93.2, C94.2, C95.2, C96.2, C97.2, C98.2, C99.2, C100.2, C101.2, C102.2, C103.2, C104.2, C105.2, C106.2, C107.2, C108.2, C109.2, C110.2, C111.2, C112.2, C113.2, C114.2, C115.2, C116.2, C117.2, C118.2, C119.2, C120.2, C121.2, C122.2, C123.2, C124.2, C125.2, C126.2, C127.2, C128.2, C129.2, C130.2, C131.2, C132.2, C133.2, C134.2, C135.2, C136.2, C137.2, C138.2, C139.2, C140.2, HOLE1.H, HOLE2.H, HOLE3.H, HOLE4.H, HOLE5.H, HOLE6.H, HOLE7.H, HOLE8.H, HOLE9.H, Q1.3 (GND), Q2.3 (GND), Q3.3 (GND), Q4.3 (GND), Q5.3 (GND), Q6.3 (GND), Q7.3 (GND), Q8.3 (GND), Q9.3 (GND), Q10.3 (GND), Q11.3 (GND), Q12.3 (GND), Q13.3 (GND), Q14.3 (GND), Q15.3 (GND), Q16.3 (GND), Q17.3 (GND), Q18.3 (GND), Q19.3 (GND), Q20.3 (GND), Q21.3 (GND), Q22.3 (GND), Q23.3 (GND), Q24.3 (GND), Q25.3 (GND), Q26.3 (GND), Q27.3 (GND), Q28.3 (GND), Q29.3 (GND), Q30.3 (GND), Q31.3 (GND), Q32.3 (GND), Q33.3 (GND), Q34.3 (GND), Q35.3 (GND), Q36.3 (GND), Q37.3 (GND), Q38.3 (GND), Q39.3 (GND), Q40.3 (GND), Q41.3 (GND), Q42.3 (GND), Q43.3 (GND), Q44.3 (GND), Q45.3 (GND), Q46.3 (GND), Q47.3 (GND), Q48.3 (GND), Q49.3 (GND), Q50.3 (GND), Q51.3 (GND), Q52.3 (GND), Q53.3 (GND), Q54.3 (GND), Q55.3 (GND), Q56.3 (GND), Q57.3 (GND), Q58.3 (GND), Q59.3 (GND), Q60.3 (GND), Q61.3 (GND), Q62.3 (GND), Q63.3 (GND), Q64.3 (GND), Q65.3 (GND), Q66.3 (GND), Q67.3 (GND), Q68.3 (GND), Q69.3 (GND), Q70.3 (GND), Q71.3 (GND), Q72.3 (GND), Q73.3 (GND), Q74.3 (GND), Q75.3 (GND), Q76.3 (GND), Q77.3 (GND), Q78.3 (GND), Q79.3 (GND), Q80.3 (GND), Q81.3 (GND), Q82.3 (GND), Q83.3 (GND), Q84.3 (GND), Q85.3 (GND), Q86.3 (GND), Q87.3 (GND), Q88.3 (GND), Q89.3 (GND), Q90.3 (GND), Q91.3 (GND), Q92.3 (GND), Q93.3 (GND), Q94.3 (GND), Q95.3 (GND), Q96.3 (GND), Q97.3 (GND), Q98.3 (GND), Q99.3 (GND), Q100.3 (GND), Q101.3 (GND), Q102.3 (GND), Q103.3 (GND), Q104.3 (GND), Q105.3 (GND), Q106.3 (GND), Q107.3 (GND), Q108.3 (GND), Q109.3 (GND), Q110.3 (GND), Q111.3 (GND), Q112.3 (GND), Q113.3 (GND), Q114.3 (GND), Q115.3 (GND), Q116.3 (GND), Q117.3 (GND), Q118.3 (GND), Q119.3 (GND), Q120.3 (GND), Q121.3 (GND), Q122.3 (GND), Q123.3 (GND), Q124.3 (GND), Q125.3 (GND), Q126.3 (GND), Q127.3 (GND), Q128.3 (GND), Q129.3 (GND), Q130.3 (GND), Q131.3 (GND), Q132.3 (GND), Q133.3 (GND), Q134.3 (GND), Q135.3 (GND), Q136.3 (GND), Q137.3 (GND), Q138.3 (GND), Q139.3 (GND), Q140.3 (GND), XL3.1, XL4.1, XL5.1, XL6.1, XL7.1
unnamed: Q1.2 (DOUT), Q2.4 (DIN), TP2.1
unnamed: Q1.4 (DIN), TP1.1, XL1.1
unnamed: Q2.2 (DOUT), Q3.4 (DIN), TP3.1
unnamed: Q3.2 (DOUT), Q4.4 (DIN), TP4.1
unnamed: Q4.2 (DOUT), Q5.4 (DIN), TP5.1
unnamed: Q5.2 (DOUT), Q6.4 (DIN), TP6.1
unnamed: Q6.2 (DOUT), Q7.4 (DIN), TP7.1
unnamed: Q7.2 (DOUT), Q8.4 (DIN), TP8.1
unnamed: Q8.2 (DOUT), Q9.4 (DIN), TP9.1
unnamed: Q10.2 (DOUT), Q11.4 (DIN), TP11.1
unnamed: Q9.2 (DOUT), Q10.4 (DIN), TP10.1
unnamed: Q11.2 (DOUT), Q12.4 (DIN), TP12.1
unnamed: Q12.2 (DOUT), Q13.4 (DIN), TP13.1
unnamed: Q13.2 (DOUT), Q14.4 (DIN), TP14.1
unnamed: Q14.2 (DOUT), Q15.4 (DIN), TP15.1
unnamed: Q15.2 (DOUT), Q16.4 (DIN), TP16.1
unnamed: Q16.2 (DOUT), Q17.4 (DIN), TP17.1
unnamed: Q17.2 (DOUT), Q18.4 (DIN), TP18.1
unnamed: Q18.2 (DOUT), Q19.4 (DIN), TP19.1
unnamed: Q19.2 (DOUT), Q20.4 (DIN), TP20.1
unnamed: Q20.2 (DOUT), Q21.4 (DIN), TP21.1
unnamed: Q21.2 (DOUT), Q22.4 (DIN), TP22.1
unnamed: Q22.2 (DOUT), Q23.4 (DIN), TP23.1
unnamed: Q23.2 (DOUT), Q24.4 (DIN), TP24.1
unnamed: Q24.2 (DOUT), Q25.4 (DIN), TP25.1
unnamed: Q25.2 (DOUT), Q26.4 (DIN), TP26.1
unnamed: Q26.2 (DOUT), Q27.4 (DIN), TP27.1
unnamed: Q27.2 (DOUT), Q28.4 (DIN), TP28.1
unnamed: Q28.2 (DOUT), Q29.4 (DIN), TP29.1
unnamed: Q29.2 (DOUT), Q30.4 (DIN), TP30.1
unnamed: Q30.2 (DOUT), Q31.4 (DIN), TP31.1
unnamed: Q31.2 (DOUT), Q32.4 (DIN), TP32.1
unnamed: Q32.2 (DOUT), Q33.4 (DIN), TP33.1
unnamed: Q33.2 (DOUT), Q34.4 (DIN), TP34.1
unnamed: Q34.2 (DOUT), Q35.4 (DIN), TP35.1
unnamed: Q35.2 (DOUT), Q36.4 (DIN), TP36.1
unnamed: Q36.2 (DOUT), Q37.4 (DIN), TP37.1
unnamed: Q37.2 (DOUT), Q38.4 (DIN), TP38.1
unnamed: Q38.2 (DOUT), Q39.4 (DIN), TP39.1
unnamed: Q39.2 (DOUT), Q40.4 (DIN), TP40.1
unnamed: Q40.2 (DOUT), Q41.4 (DIN), TP41.1
unnamed: Q41.2 (DOUT), Q42.4 (DIN), TP42.1
unnamed: Q42.2 (DOUT), Q43.4 (DIN), TP43.1
unnamed: Q43.2 (DOUT), Q44.4 (DIN), TP44.1
unnamed: Q44.2 (DOUT), Q45.4 (DIN), TP45.1
unnamed: Q45.2 (DOUT), Q46.4 (DIN), TP46.1
unnamed: Q46.2 (DOUT), Q47.4 (DIN), TP47.1
unnamed: Q47.2 (DOUT), Q48.4 (DIN), TP48.1
unnamed: Q48.2 (DOUT), Q49.4 (DIN), TP49.1
unnamed: Q49.2 (DOUT), Q50.4 (DIN), TP50.1
unnamed: Q50.2 (DOUT), Q51.4 (DIN), TP51.1
unnamed: Q51.2 (DOUT), Q52.4 (DIN), TP52.1
unnamed: Q52.2 (DOUT), Q53.4 (DIN), TP53.1
unnamed: Q53.2 (DOUT), Q54.4 (DIN), TP54.1
unnamed: Q54.2 (DOUT), Q55.4 (DIN), TP55.1
unnamed: Q55.2 (DOUT), Q56.4 (DIN), TP56.1
unnamed: Q56.2 (DOUT), Q57.4 (DIN), TP57.1
unnamed: Q57.2 (DOUT), Q58.4 (DIN), TP58.1
unnamed: Q58.2 (DOUT), Q59.4 (DIN), TP59.1
unnamed: Q59.2 (DOUT), Q60.4 (DIN), TP60.1
unnamed: Q60.2 (DOUT), Q61.4 (DIN), TP61.1
unnamed: Q61.2 (DOUT), Q62.4 (DIN), TP62.1
unnamed: Q62.2 (DOUT), Q63.4 (DIN), TP63.1
unnamed: Q63.2 (DOUT), Q64.4 (DIN), TP64.1
unnamed: Q64.2 (DOUT), Q65.4 (DIN), TP65.1
unnamed: Q65.2 (DOUT), Q66.4 (DIN), TP66.1
unnamed: Q66.2 (DOUT), Q67.4 (DIN), TP67.1
unnamed: Q67.2 (DOUT), Q68.4 (DIN), TP68.1
unnamed: Q68.2 (DOUT), Q69.4 (DIN), TP69.1
unnamed: Q69.2 (DOUT), Q70.4 (DIN), TP70.1
unnamed: Q70.2 (DOUT), Q71.4 (DIN), TP71.1
unnamed: Q71.2 (DOUT), Q72.4 (DIN), TP72.1
unnamed: Q72.2 (DOUT), Q73.4 (DIN), TP73.1
unnamed: Q73.2 (DOUT), Q74.4 (DIN), TP74.1
unnamed: Q74.2 (DOUT), Q75.4 (DIN), TP75.1
unnamed: Q75.2 (DOUT), Q76.4 (DIN), TP76.1
unnamed: Q76.2 (DOUT), Q77.4 (DIN), TP77.1
unnamed: Q77.2 (DOUT), Q78.4 (DIN), TP78.1
unnamed: Q78.2 (DOUT), Q79.4 (DIN), TP79.1
unnamed: Q79.2 (DOUT), Q80.4 (DIN), TP80.1
unnamed: Q80.2 (DOUT), Q81.4 (DIN), TP81.1
unnamed: Q81.2 (DOUT), Q82.4 (DIN), TP82.1
unnamed: Q82.2 (DOUT), Q83.4 (DIN), TP83.1
unnamed: Q83.2 (DOUT), Q84.4 (DIN), TP84.1
unnamed: Q84.2 (DOUT), Q85.4 (DIN), TP85.1
unnamed: Q85.2 (DOUT), Q86.4 (DIN), TP86.1
unnamed: Q86.2 (DOUT), Q87.4 (DIN), TP87.1
unnamed: Q87.2 (DOUT), Q88.4 (DIN), TP88.1
unnamed: Q88.2 (DOUT), Q89.4 (DIN), TP89.1
unnamed: Q89.2 (DOUT), Q90.4 (DIN), TP90.1
unnamed: Q90.2 (DOUT), Q91.4 (DIN), TP91.1
unnamed: Q91.2 (DOUT), Q92.4 (DIN), TP92.1
unnamed: Q92.2 (DOUT), Q93.4 (DIN), TP93.1
unnamed: Q93.2 (DOUT), Q94.4 (DIN), TP94.1
unnamed: Q94.2 (DOUT), Q95.4 (DIN), TP95.1
unnamed: Q95.2 (DOUT), Q96.4 (DIN), TP96.1
unnamed: Q96.2 (DOUT), Q97.4 (DIN), TP97.1
unnamed: Q97.2 (DOUT), Q98.4 (DIN), TP98.1
unnamed: Q98.2 (DOUT), Q99.4 (DIN), TP99.1
unnamed: Q100.2 (DOUT), Q101.4 (DIN), TP101.1
unnamed: Q99.2 (DOUT), Q100.4 (DIN), TP100.1
unnamed: Q101.2 (DOUT), Q102.4 (DIN), TP102.1
unnamed: Q102.2 (DOUT), Q103.4 (DIN), TP103.1
unnamed: Q103.2 (DOUT), Q104.4 (DIN), TP104.1
unnamed: Q105.2 (DOUT), Q106.4 (DIN), TP106.1
unnamed: Q106.2 (DOUT), Q107.4 (DIN), TP107.1
unnamed: Q107.2 (DOUT), Q108.4 (DIN), TP108.1
unnamed: Q108.2 (DOUT), Q109.4 (DIN), TP109.1
unnamed: Q109.2 (DOUT), Q110.4 (DIN), TP110.1
unnamed: Q110.2 (DOUT), Q111.4 (DIN), TP111.1
unnamed: Q111.2 (DOUT), Q112.4 (DIN), TP112.1
unnamed: Q112.2 (DOUT), Q113.4 (DIN), TP113.1
unnamed: Q113.2 (DOUT), Q114.4 (DIN), TP114.1
unnamed: Q114.2 (DOUT), Q115.4 (DIN), TP115.1
unnamed: Q115.2 (DOUT), Q116.4 (DIN), TP116.1
unnamed: Q116.2 (DOUT), Q117.4 (DIN), TP117.1
unnamed: Q117.2 (DOUT), Q118.4 (DIN), TP118.1
unnamed: Q118.2 (DOUT), Q119.4 (DIN), TP119.1
unnamed: Q119.2 (DOUT), Q120.4 (DIN), TP120.1
unnamed: Q120.2 (DOUT), Q121.4 (DIN), TP121.1
unnamed: Q121.2 (DOUT), Q122.4 (DIN), TP122.1
unnamed: Q122.2 (DOUT), Q123.4 (DIN), TP123.1
unnamed: Q123.2 (DOUT), Q124.4 (DIN), TP124.1
unnamed: Q124.2 (DOUT), Q125.4 (DIN), TP125.1
unnamed: Q125.2 (DOUT), Q126.4 (DIN), TP126.1
unnamed: Q126.2 (DOUT), Q127.4 (DIN), TP127.1
unnamed: Q127.2 (DOUT), Q128.4 (DIN), TP128.1
unnamed: Q128.2 (DOUT), Q129.4 (DIN), TP129.1
unnamed: Q129.2 (DOUT), Q130.4 (DIN), TP130.1
unnamed: Q130.2 (DOUT), Q131.4 (DIN), TP131.1
unnamed: Q131.2 (DOUT), Q132.4 (DIN), TP132.1
unnamed: Q132.2 (DOUT), Q133.4 (DIN), TP133.1
unnamed: Q133.2 (DOUT), Q134.4 (DIN), TP134.1
unnamed: Q134.2 (DOUT), Q135.4 (DIN), TP135.1
unnamed: Q135.2 (DOUT), Q136.4 (DIN), TP136.1
unnamed: Q136.2 (DOUT), Q137.4 (DIN), TP137.1
unnamed: Q137.2 (DOUT), Q138.4 (DIN), TP138.1
unnamed: Q138.2 (DOUT), Q139.4 (DIN), TP139.1
unnamed: Q139.2 (DOUT), Q140.4 (DIN), TP140.1
unnamed: Q140.2 (DOUT), XL2.1
unnamed: Q104.2 (DOUT), Q105.4 (DIN), TP105.1

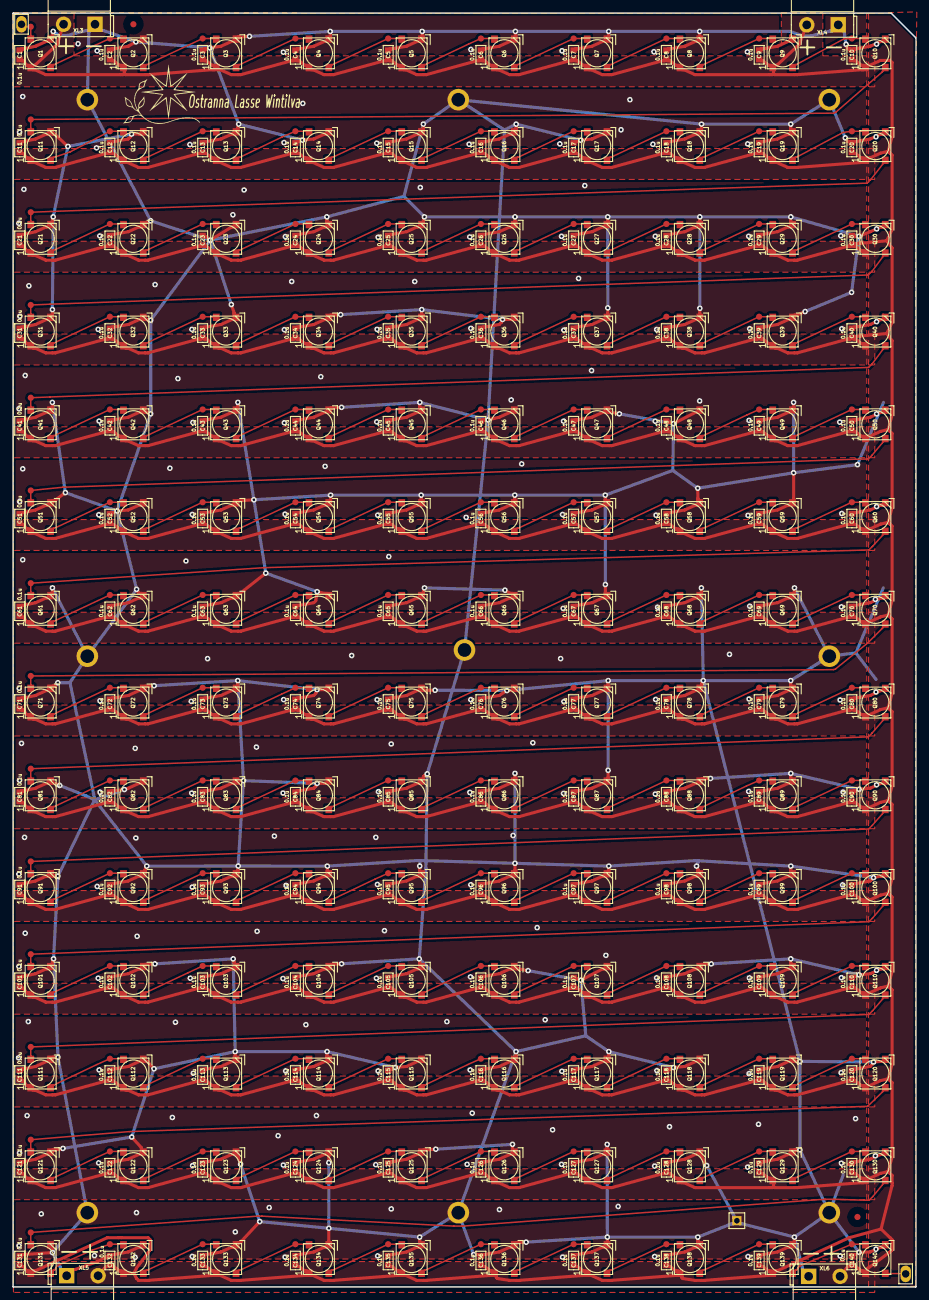
[picture p7: board LedPcb10x14.kicad_pcb from above]

Board: 2 copper layers, 146.0 x 206.0 mm, 439 parts (0 on the bottom side), 143 nets.
