Kreyl/LedPicture/CubeL476/CubeL476.ioc

Mcu.UserName=STM32L476RCTx
PA0.Signal=GPIO_Input
PA1.Signal=GPIO_Input
PA10.Signal=USART1_RX
PA11.Signal=USB_OTG_FS_DM
PA12.Signal=USB_OTG_FS_DP
PA2.Signal=GPIO_Input
PA3.Signal=GPIO_Input
PA4.Signal=GPIO_Output
PA5.Signal=SPI1_SCK
PA6.Signal=SPI1_MISO
PA7.Signal=SPI1_MOSI
PA9.Signal=USART1_TX
PB13.Signal=SPI2_SCK
PB15.Signal=SPI2_MOSI
PB5.Signal=S_TIM3_CH2
PB9.Signal=S_TIM17_CH1
PC0.Signal=I2C3_SCL
PC1.Signal=I2C3_SDA
PC10.Signal=SPI3_SCK
PC12.Signal=SPI3_MOSI
PC4.Signal=GPIO_Input
PC5.Signal=GPIO_Input
