Kreyl/LedPicture/LedPicture_fw/board.h

/*
 * board.h
 *
 *  Created on: 05 08 2018
 *      Author: Kreyl
 */

#pragma once

// ==== General ====
#define APP_NAME            "LedPicture"

// Version of PCB
#define PCB_VER                 1

// MCU type as defined in the ST header.
#define STM32L476xx

// Freq of external crystal if any. Leave it here even if not used.
#define CRYSTAL_FREQ_HZ         12000000

// OS timer settings
#define STM32_ST_IRQ_PRIORITY   2
#define STM32_ST_USE_TIMER      5
#define SYS_TIM_CLK             (Clk.APB1FreqHz)    // Timer 5 is clocked by APB1

//  Periphery
#define I2C1_ENABLED            FALSE
#define I2C2_ENABLED            FALSE
#define I2C3_ENABLED            TRUE

#define ADC_REQUIRED            FALSE
#define STM32_DMA_REQUIRED      TRUE    // Leave this macro name for OS

#if 1 // ========================== GPIO =======================================
// EXTI
#define INDIVIDUAL_EXTI_IRQ_REQUIRED    FALSE

// UART
#define UART_GPIO       GPIOA
#define UART_TX_PIN     9
#define UART_RX_PIN     10

// Different pins
#define PWR_EN          GPIOD, 2, omPushPull

// LED
#define LED_PIN         { GPIOB, 9, TIM17, 1, invNotInverted, omPushPull, 255 }

// Neopixel LEDs
#define NPX_LED_CNT     560
#define NPX_SPI         SPI2
#define NPX_GPIO        GPIOB
#define NPX_PIN         15
#define NPX_AF          AF5

#define NPX2_LED_CNT    25
#define NPX2_SPI        SPI3
#define NPX2_GPIO       GPIOC
#define NPX2_PIN        12
#define NPX2_AF         AF6

// ==== Lora ====
#define SX_SPI          SPI1
#define SX_SCK          GPIOA,  5, omPushPull, pudNone, AF5
#define SX_MISO         GPIOA,  6, omPushPull, pudNone, AF5
#define SX_MOSI         GPIOA,  7, omPushPull, pudNone, AF5
#define SX_NSS          GPIOA, 4
#define SX_NRESET       GPIOC, 3
#define SX_DIO0_GPIO    GPIOA
#define SX_DIO0_PIN     0
#define SX_DIO1_GPIO    GPIOA
#define SX_DIO1_PIN     1
#define SX_DIO2_GPIO    GPIOA
#define SX_DIO2_PIN     2
#define SX_DIO3_GPIO    GPIOA
#define SX_DIO3_PIN     3
#define SX_DIO4_GPIO    GPIOC
#define SX_DIO4_PIN     5
#define SX_DIO5_GPIO    GPIOC
#define SX_DIO5_PIN     4

// I2C
#define I2C1_GPIO       GPIOB
#define I2C1_SCL        6
#define I2C1_SDA        7
#define I2C2_GPIO       GPIOB
#define I2C2_SCL        10
#define I2C2_SDA        11
#define I2C3_GPIO       GPIOC
#define I2C3_SCL        0
#define I2C3_SDA        1
// I2C Alternate Function
#define I2C_AF          AF4

// USB
#define USB_DM          GPIOA, 11
#define USB_DP          GPIOA, 12
#define USB_AF          AF10
// USB detect
#define USB_DETECT_PIN  GPIOC, 9

#endif // GPIO

#if 1 // =========================== I2C =======================================
// i2cclkPCLK1, i2cclkSYSCLK, i2cclkHSI
#define I2C_CLK_SRC     i2cclkHSI
#define I2C_BAUDRATE_HZ 400000
#endif

#if ADC_REQUIRED // ======================= Inner ADC ==========================
// Clock divider: clock is generated from the APB2
#define ADC_CLK_DIVIDER		adcDiv2

// ADC channels
#define ADC_BATTERY_CHNL 	14
// ADC_VREFINT_CHNL
#define ADC_CHANNELS        { ADC_BATTERY_CHNL, ADC_VREFINT_CHNL }
#define ADC_CHANNEL_CNT     2   // Do not use countof(AdcChannels) as preprocessor does not know what is countof => cannot check
#define ADC_SAMPLE_TIME     ast24d5Cycles
#define ADC_OVERSAMPLING_RATIO  64   // 1 (no oversampling), 2, 4, 8, 16, 32, 64, 128, 256
#endif

#if 1 // =========================== DMA =======================================
// ==== Uart ====
// Remap is made automatically if required
#define UART_DMA_TX     STM32_DMA_STREAM_ID(2, 6)
#define UART_DMA_RX     STM32_DMA_STREAM_ID(2, 7)
#define UART_DMA_CHNL   2
#define UART_DMA_TX_MODE(Chnl) (STM32_DMA_CR_CHSEL(Chnl) | DMA_PRIORITY_LOW | STM32_DMA_CR_MSIZE_BYTE | STM32_DMA_CR_PSIZE_BYTE | STM32_DMA_CR_MINC | STM32_DMA_CR_DIR_M2P | STM32_DMA_CR_TCIE)
#define UART_DMA_RX_MODE(Chnl) (STM32_DMA_CR_CHSEL(Chnl) | DMA_PRIORITY_MEDIUM | STM32_DMA_CR_MSIZE_BYTE | STM32_DMA_CR_PSIZE_BYTE | STM32_DMA_CR_MINC | STM32_DMA_CR_DIR_P2M | STM32_DMA_CR_CIRC)

// ==== I2C ====
#define I2C_USE_DMA     TRUE
#define I2C1_DMA_TX     STM32_DMA_STREAM_ID(1, 6)
#define I2C1_DMA_RX     STM32_DMA_STREAM_ID(1, 7)
#define I2C1_DMA_CHNL   3
#define I2C2_DMA_TX     STM32_DMA_STREAM_ID(1, 4)
#define I2C2_DMA_RX     STM32_DMA_STREAM_ID(1, 5)
#define I2C2_DMA_CHNL   3
#define I2C3_DMA_TX     STM32_DMA_STREAM_ID(1, 2)
#define I2C3_DMA_RX     STM32_DMA_STREAM_ID(1, 3)
#define I2C3_DMA_CHNL   3

#define NPX_DMA         STM32_DMA_STREAM_ID(1, 5)
#define NPX_DMA_CHNL    1

#if ADC_REQUIRED
#define ADC_DMA         STM32_DMA1_STREAM1
#define ADC_DMA_MODE    STM32_DMA_CR_CHSEL(0) |   /* DMA1 Stream1 Channel0 */ \
                        DMA_PRIORITY_LOW | \
                        STM32_DMA_CR_MSIZE_HWORD | \
                        STM32_DMA_CR_PSIZE_HWORD | \
                        STM32_DMA_CR_MINC |       /* Memory pointer increase */ \
                        STM32_DMA_CR_DIR_P2M |    /* Direction is peripheral to memory */ \
                        STM32_DMA_CR_TCIE         /* Enable Transmission Complete IRQ */
#endif // ADC

#endif // DMA

#if 1 // ========================== USART ======================================
#define PRINTF_FLOAT_EN FALSE
#define UART_TXBUF_SZ   4096
#define UART_RXBUF_SZ   99
#define CMD_BUF_SZ      256

#define CMD_UART        USART1

#define CMD_UART_PARAMS \
    CMD_UART, UART_GPIO, UART_TX_PIN, UART_GPIO, UART_RX_PIN, \
    UART_DMA_TX, UART_DMA_RX, UART_DMA_TX_MODE(UART_DMA_CHNL), UART_DMA_RX_MODE(UART_DMA_CHNL), \
    uartclkHSI // Use independent clock

#endif
