Kreyl/LedPicture/LedPicture_fw/kl_lib/color.h

/*
 * color.h
 *
 *  Created on: 05 ���. 2014 �.
 *      Author: Kreyl
 */

#pragma once

#include "kl_lib.h"
#include "inttypes.h"
#include <sys/cdefs.h>
#include <stdlib.h> // for random

void Printf(const char *format, ...);

struct ColorHSV_t;

// In Settings, if Color.Brt == RANDOM_CLR_BRT then color should be random.
// The check and transmutation shall be made in upper level.
#define RANDOM_CLR_BRT      255

// Mixing two colors
#define ClrMix(Fore, Back, Weight)     ((Fore * Weight + Back * (255 - Weight)) / 255)

__attribute__((__always_inline__))
static inline int32_t Abs32(int32_t w) { return (w < 0)? -w : w; }

// Smooth delay
static inline uint32_t ClrCalcDelay(uint16_t AValue, uint32_t Smooth) {
    return (uint32_t)((Smooth / (AValue+4)) + 1);
}

// Calculate Smooth value from desired duration of switching
static inline int32_t CalcSmooth_st_from_ms(int32_t Duration_ms) {
    return (TIME_MS2I(Duration_ms) * 10L) / 36L;
}

struct Color_t {
private:
    __always_inline
    uint8_t SetSingleBrt(int32_t v, const int32_t Brt, const int32_t BrtMax) {
        if(v > 0) {
            v = (v * Brt) / BrtMax;
            if(v == 0) v = 1;
        }
        return v;
    }
public:
    union {
        uint32_t DWord32;
        struct {
            uint8_t R, G, B;
            union {
                uint8_t Brt, W;
            };
        } __attribute__((packed));
    };
    bool operator == (const Color_t &AColor) const { return (DWord32 == AColor.DWord32); }
    bool operator != (const Color_t &AColor) const { return (DWord32 != AColor.DWord32); }
    Color_t& operator = (const Color_t &Right) { DWord32 = Right.DWord32; return *this; }
    void Adjust(const Color_t &PColor) {
        if     (R < PColor.R) R++;
        else if(R > PColor.R) R--;
        if     (G < PColor.G) G++;
        else if(G > PColor.G) G--;
        if     (B < PColor.B) B++;
        else if(B > PColor.B) B--;
        if     (Brt < PColor.Brt) Brt++;
        else if(Brt > PColor.Brt) Brt--;
    }
    void Adjust(const Color_t &PColor, uint32_t Step, const int32_t BrtMax) {
        uint32_t ThrsR = 255 - Step;
        if(R < PColor.R) {
            if(R <= ThrsR) R += Step;
            else R = 255;
        }
        else if(R > PColor.R) {
            if(R >= Step) R -= Step;
            else R = 0;
        }

        if(G < PColor.G) {
            if(G <= ThrsR) G += Step;
            else G = 255;
        }
        else if(G > PColor.G) {
            if(G >= Step) G -= Step;
            else G = 0;
        }

        if(B < PColor.B) {
            if(B <= ThrsR) B += Step;
            else B = 255;
        }
        else if(B > PColor.B) {
            if(B >= Step) B -= Step;
            else B = 0;
        }

        if(Brt < PColor.Brt) {
            Brt += Step;
            if(Brt > BrtMax) Brt = BrtMax;
        }
        else if(Brt > PColor.Brt) {
            if(Brt >= Step) Brt -= Step;
            else Brt = 0;
        }
    }
    void FromRGB(uint8_t Red, uint8_t Green, uint8_t Blue) { R = Red; G = Green; B = Blue; }
    void ToRGB(uint8_t *PR, uint8_t *PG, uint8_t *PB) const { *PR = R; *PG = G; *PB = B; }
    bool IsEqualRGB(uint8_t Red, uint8_t Green, uint8_t Blue) { return (R == Red and G == Green and B == Blue); }

    // H: 0...360, S: 0...100, V: 0...100
    void FromHSV(uint16_t H, uint8_t S, uint8_t V) {
        // Calc chroma: 0...255
        int32_t C = ((int32_t)V * (int32_t)S * 255) / 10000;
        // Tmp values
        int32_t X = 60 - Abs32((H % 120) - 60); // 0...60
        X = (C * X) / 60;
        int32_t m = (((int32_t)V * 255) / 100) - C; // To add the same amount to each component, to match lightness
        // RGB
        if     (H < 60)  { R = C+m; G = X+m; B = m;   } // [0; 60)
        else if(H < 120) { R = X+m; G = C+m; B = m;   }
        else if(H < 180) { R = m;   G = C+m; B = X+m; }
        else if(H < 240) { R = m;   G = X+m; B = C+m; }
        else if(H < 300) { R = X+m; G = m;   B = C+m; }
        else             { R = C+m; G = m;   B = X+m; } // [300; 360]
    }

    bool IsRandom() const { return (R == 0 and G == 0 and B == 0 and Brt == RANDOM_CLR_BRT); }
    void BeRandom() { DWord32 = 0; Brt = RANDOM_CLR_BRT; }
    void GenerateRandomRGB() {
        FromHSV(Random::Generate(0, 360), 100, 100);
    }

    Color_t GetRandomIfIsRandom() {
        if(IsRandom()) {
            Color_t Rslt;
            Rslt.GenerateRandomRGB();
            return Rslt;
        }
        else return *this;
    }

    uint8_t RGBTo565_HiByte() const {
        uint32_t rslt = R & 0b11111000;
        rslt |= G >> 5;
        return (uint8_t)rslt;
    }
    uint8_t RGBTo565_LoByte() const {
        uint32_t rslt = (G << 3) & 0b11100000;
        rslt |= B >> 3;
        return (uint8_t)rslt;
    }
    uint16_t RGBTo565() const {
        uint16_t rslt = ((uint16_t)(R & 0b11111000)) << 8;
        rslt |= ((uint16_t)(G & 0b11111100)) << 3;
        rslt |= ((uint16_t)B) >> 3;
        return rslt;
    }
    // ==== Mixage ====
    // Weight = 0: result is Back; Weight = 255: result is Fore; otherwise result is mix
    void MixwWeight(const Color_t &Fore, const Color_t &Back, uint32_t Weight) {
        R = ClrMix(Fore.R, Back.R, Weight);
        G = ClrMix(Fore.G, Back.G, Weight);
        B = ClrMix(Fore.B, Back.B, Weight);
    }
    // Weight = 0: not changed; Weight = 255: result is Fore; otherwise result is mix
    void MixwWeight(const Color_t &Fore, uint32_t Weight) {
        R = ClrMix(Fore.R, R, Weight);
        G = ClrMix(Fore.G, G, Weight);
        B = ClrMix(Fore.B, B, Weight);
    }
    void MixWith(const Color_t &Clr) {
        if(Clr.Brt == 0) return;    // Alien is off, no changes with us
        else if(Brt == 0) DWord32 = Clr.DWord32; // We are off
        else {
            uint32_t BrtSum = (uint32_t)Brt + (uint32_t)Clr.Brt;
            R = (uint8_t)(((uint32_t)R * (uint32_t)Brt + (uint32_t)Clr.R * (uint32_t)Clr.Brt) / BrtSum);
            G = (uint8_t)(((uint32_t)G * (uint32_t)Brt + (uint32_t)Clr.G * (uint32_t)Clr.Brt) / BrtSum);
            B = (uint8_t)(((uint32_t)B * (uint32_t)Brt + (uint32_t)Clr.B * (uint32_t)Clr.Brt) / BrtSum);
            if(Brt < Clr.Brt) Brt = Clr.Brt; // Top brightness wins
        }
    }

    // Adjustment
    uint32_t DelayToNextAdj(const Color_t &AClr, uint32_t SmoothValue) {
        uint32_t Delay, Delay2;
        Delay = (R == AClr.R)? 0 : ClrCalcDelay(R, SmoothValue);
        Delay2 = (G == AClr.G)? 0 : ClrCalcDelay(G, SmoothValue);
        if(Delay2 > Delay) Delay = Delay2;
        Delay2 = (B == AClr.B)? 0 : ClrCalcDelay(B, SmoothValue);
        if(Delay2 > Delay) Delay = Delay2;
        Delay2 = (Brt == AClr.Brt)? 0 : ClrCalcDelay(Brt, SmoothValue);
        return (Delay2 > Delay)? Delay2 : Delay;
    }
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
