Kreyl/LedPicture/(commit log)

2021-07-11 PCBs sent to factory
    [LedPcb10x14.kicad_pcb, LedPcb10x14.kicad_sch, LedPicture.kicad_pcb, LedPicture.kicad_sch, LoRa.kicad_sch]
2021-07-17 + OS works + Antenna tuned
    [LedPicture.kicad_sch, LoRa.kicad_sch]
2021-07-19 First LORA Rx ok
    [LedPicture.kicad_sch, LoRa.kicad_sch]
2021-07-19 * Fixed payload length in RX
    [Lora.cpp, Lora.h, main.cpp]
